lazbboregi/custom-expansion-board/staj_proje.pdf

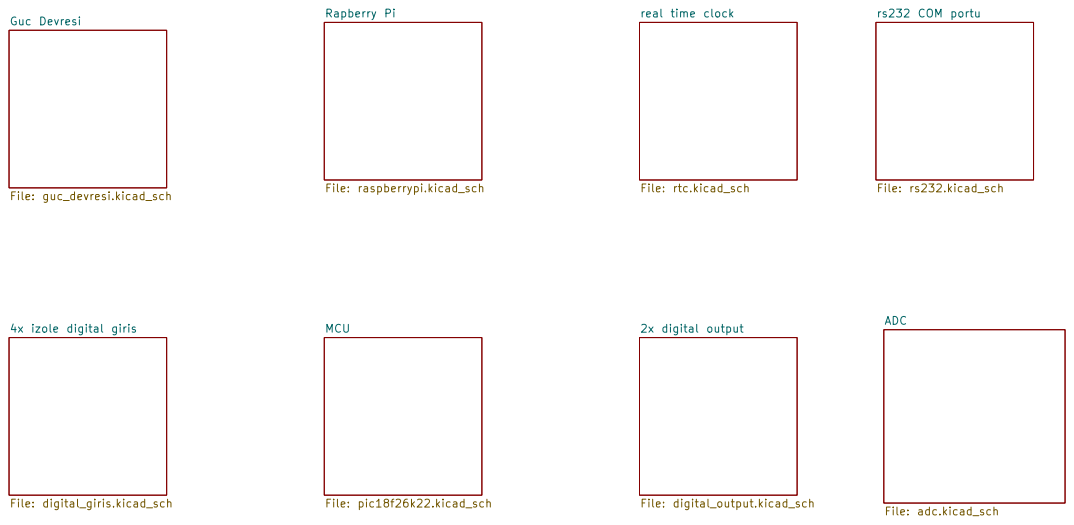
[picture p1: page 1]

File: adc.kicad_sch Rapberry Pi File: raspberrypi.kicad_sch

Size: A4 | Rev:
KiCad E.D.A. 10.0.3 | Id: 1/9

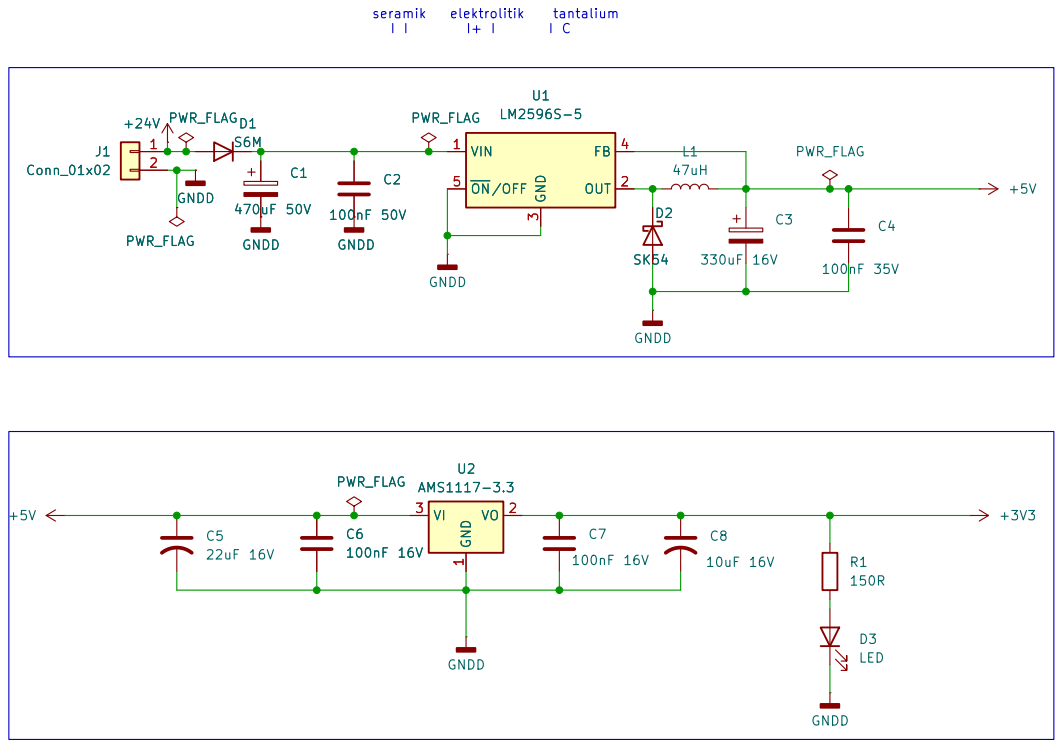
[picture p2: page 2]

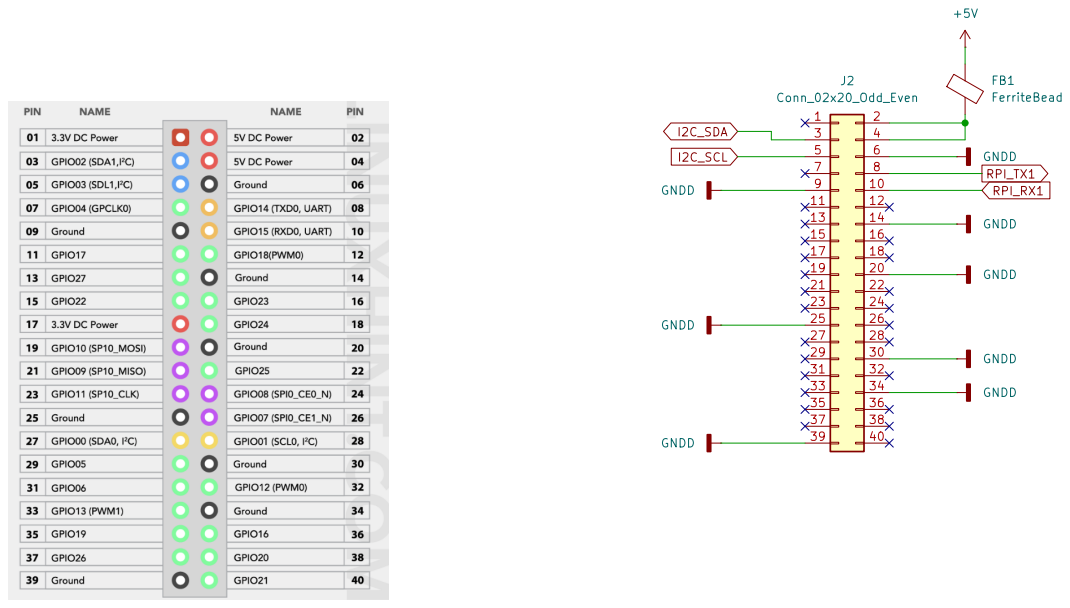
[picture p3: page 3]

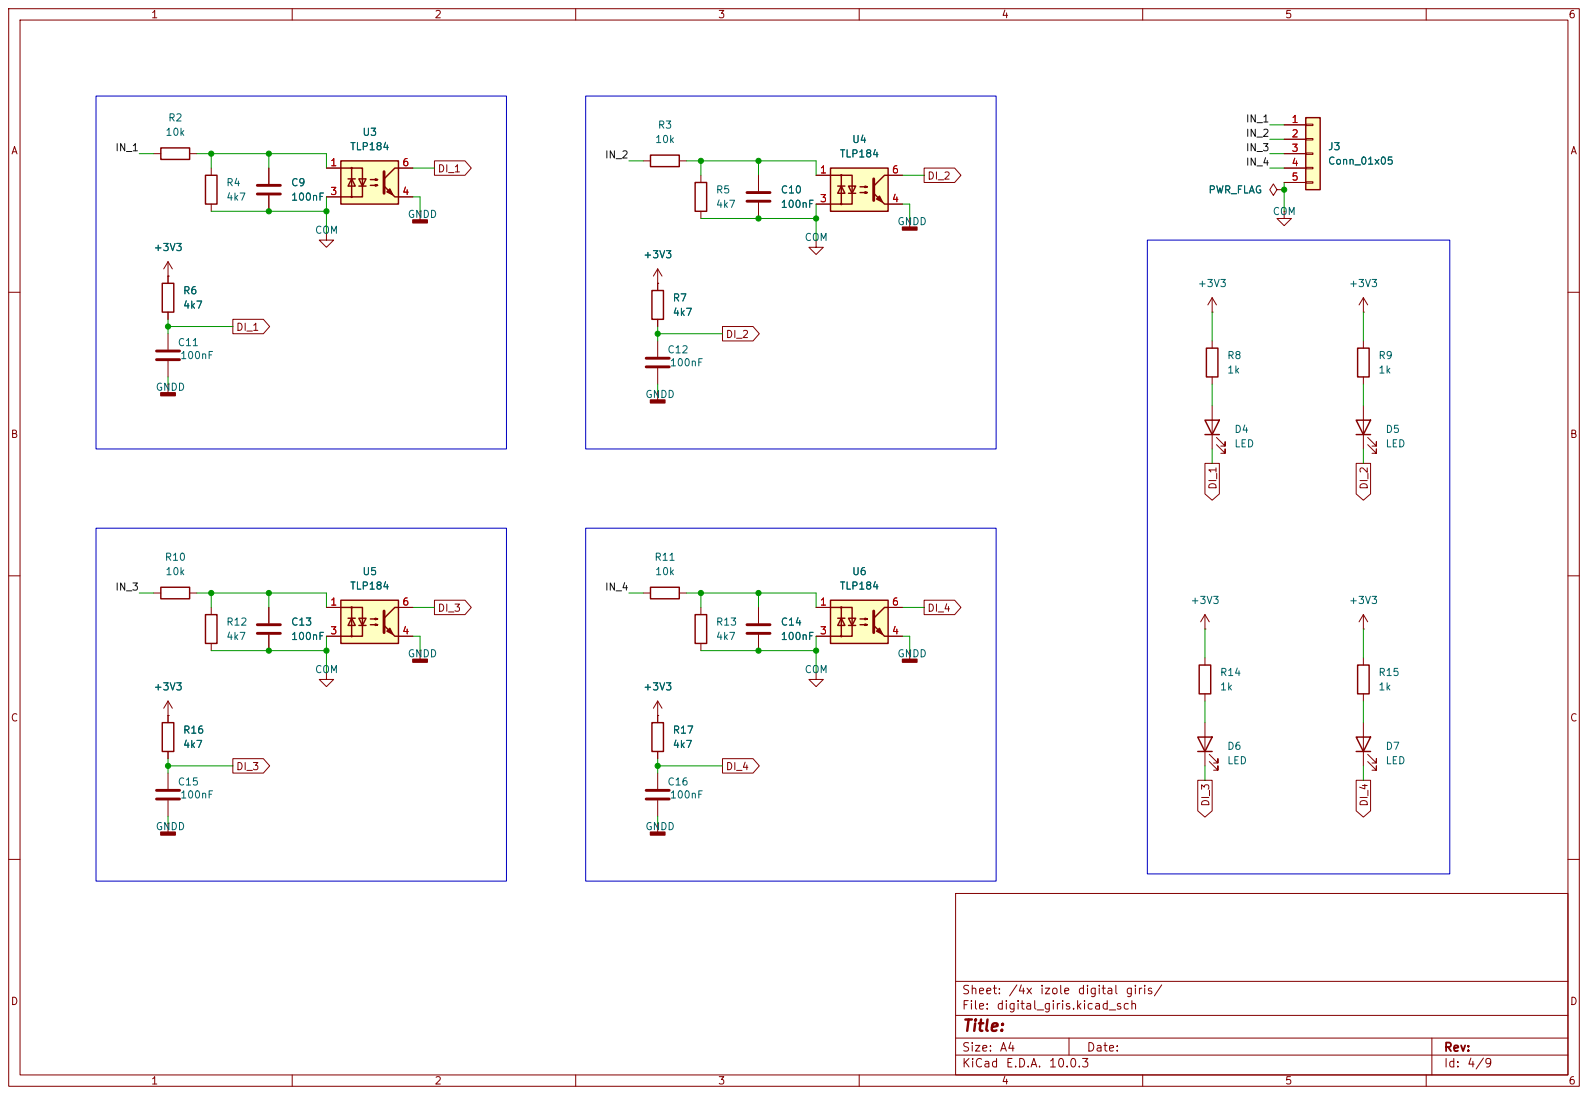
[picture p4: page 4]

Sheet: /4x izole digital giris/
File: digital_giris.kicad_sch
Title:

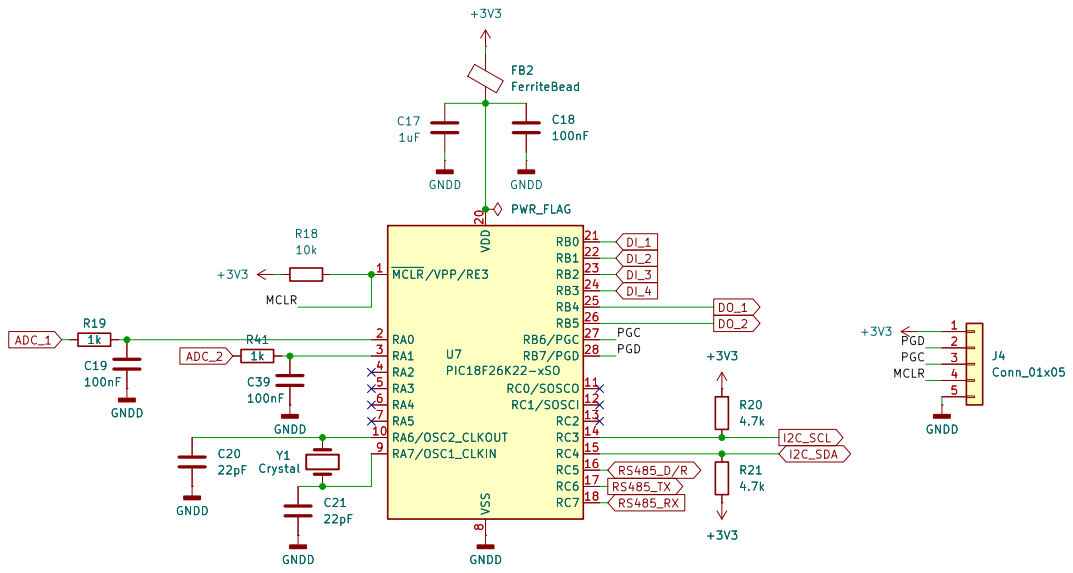
[picture p5: page 5]

8 RA7/OSC1_CLKIN 9 RA6/OSC2_CLKOUT 10 RC0/SOSCO 11 RC1/SOSCI 12 RC2 13 RC3 14 RC4 15 RC5 16 RC6 17 RC7 18 VDD 20 RB0 21 RB1 22 RB2 23 RB3 24 RB4 25 RB5 26 RB6/PGC 27 RB7/PGD 28 C21

8 RA7/OSC1_CLKIN 9 RA6/OSC2_CLKOUT 10 RC0/SOSCO 11 RC1/SOSCI 12 RC2 13 RC3 14 RC4 15 RC5 16 RC6 17 RC7 18 VDD 20 RB0 21 RB1 22 RB2 23 RB3 24 RB4 25 RB5 26 RB6/PGC 27 RB7/PGD 28 U7PIC18F26K22-xSO

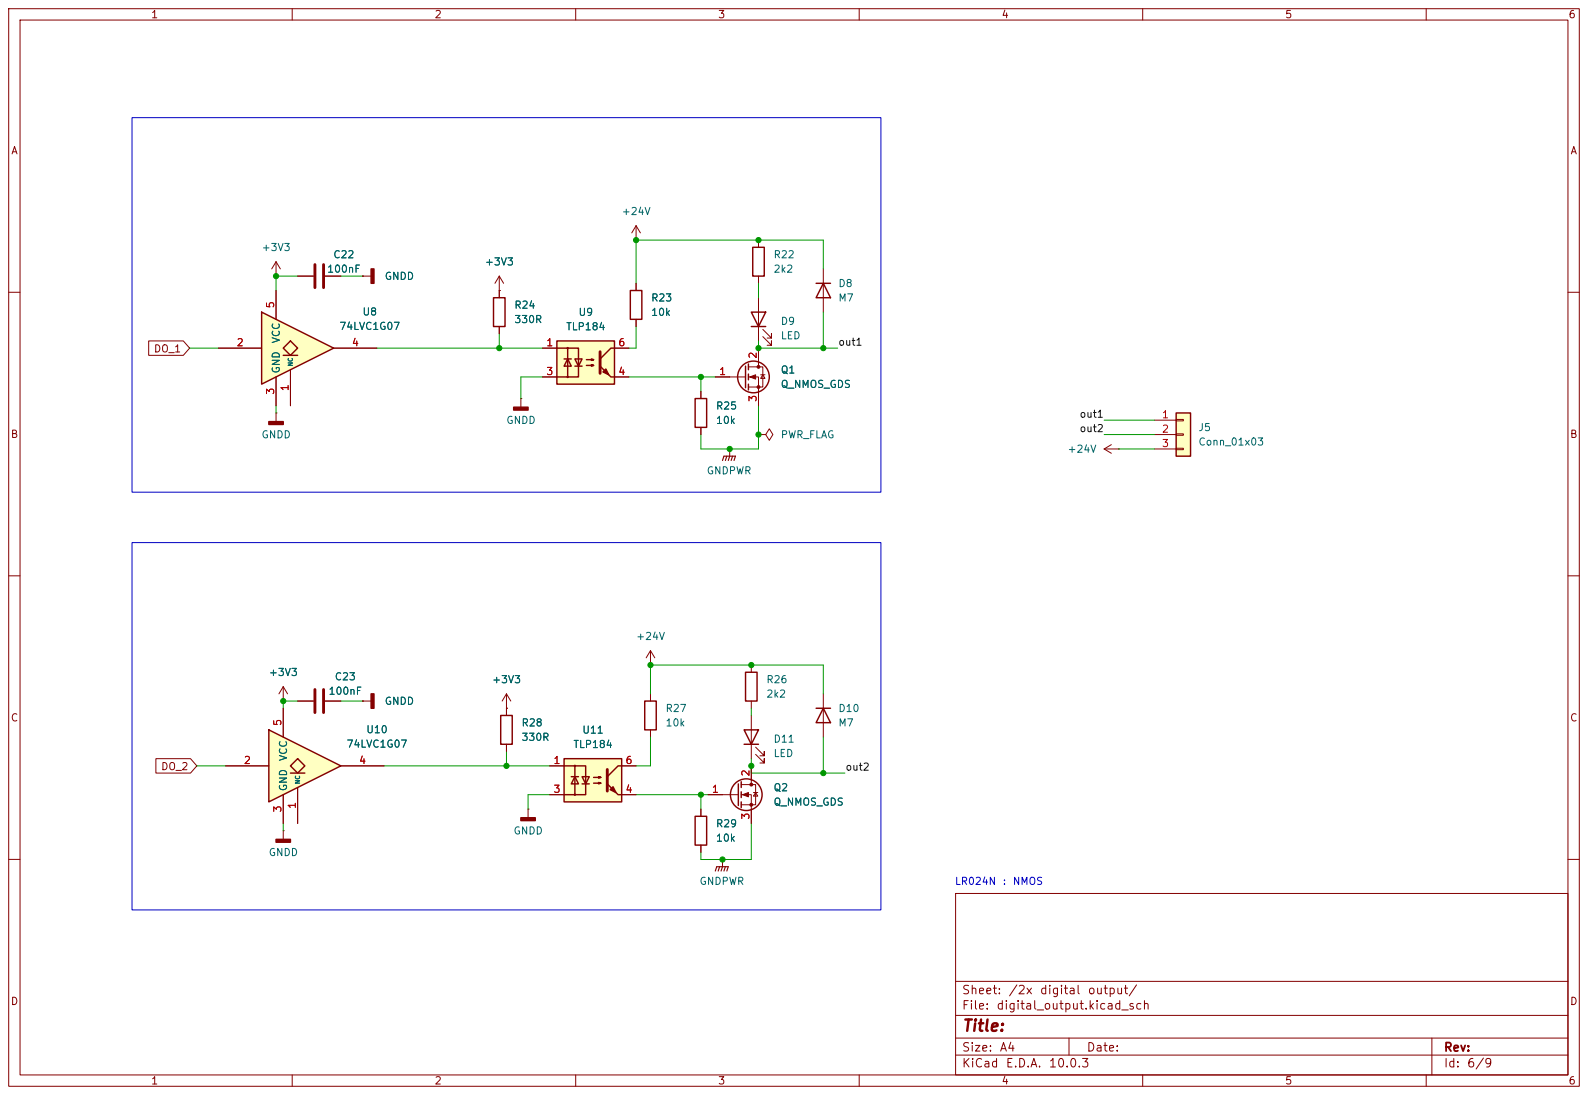
[picture p6: page 6]

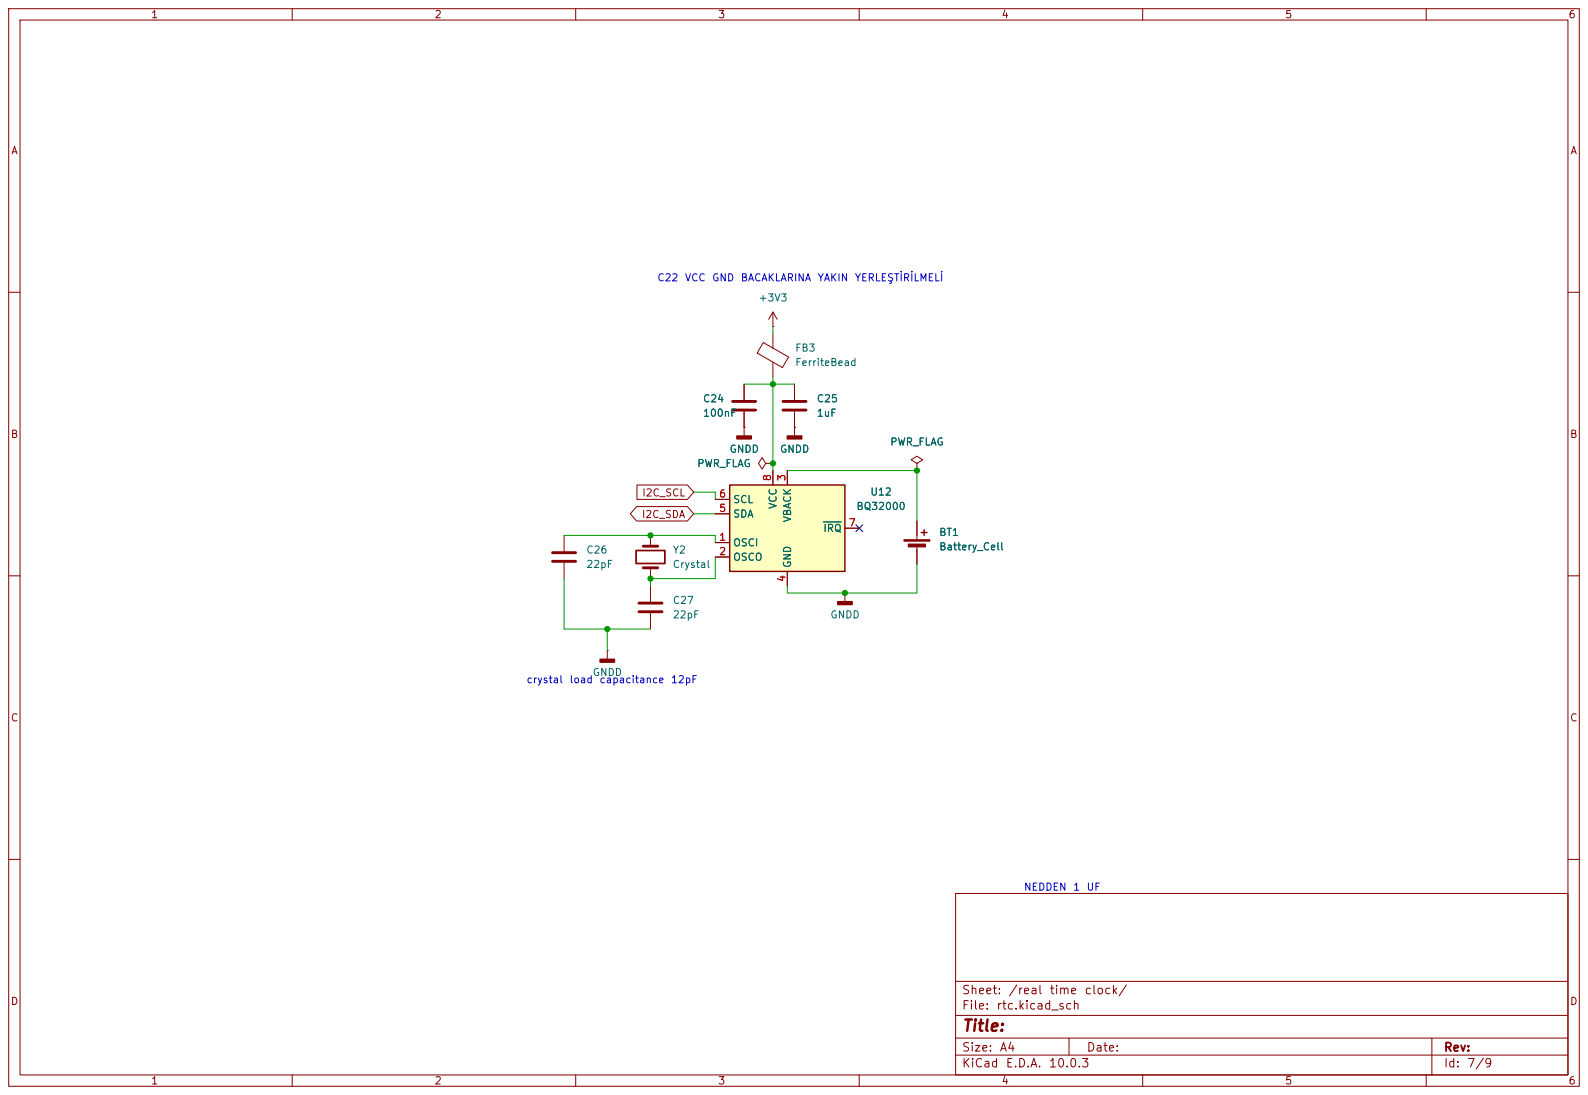
[picture p7: page 7]

Sheet: /real time clock/
File: rtc.kicad_sch
Title:

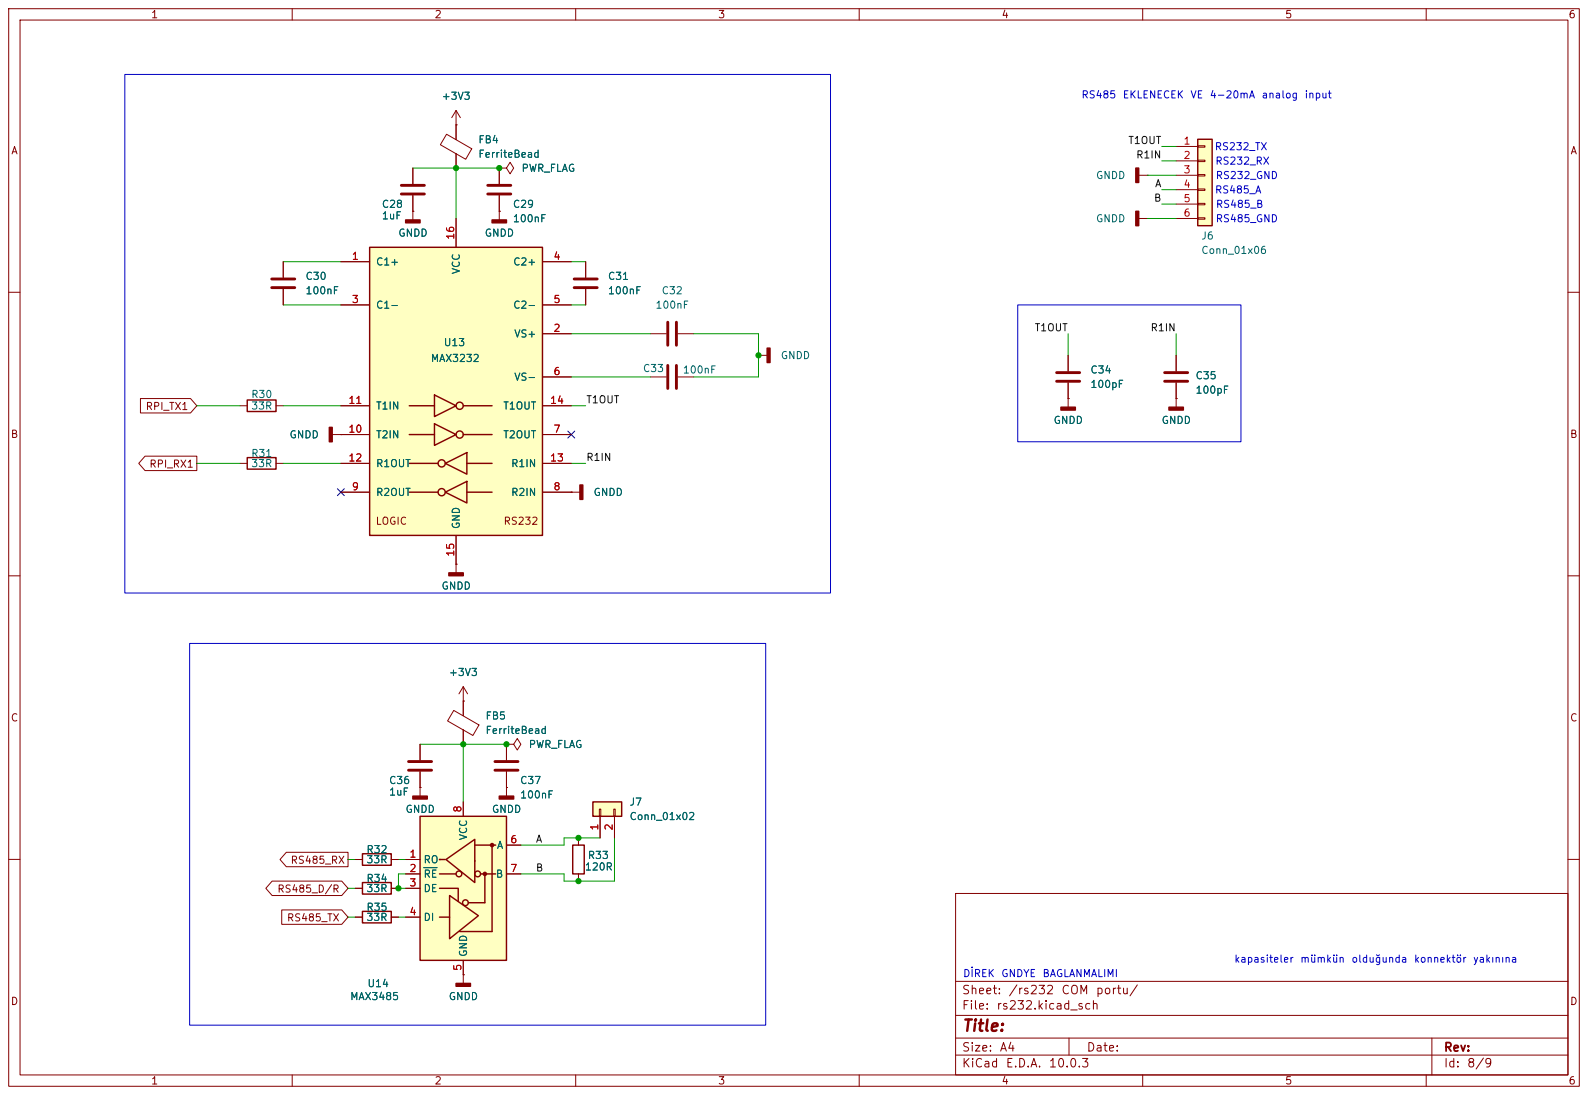
[picture p8: page 8]

RS485 EKLENECEK VE 4-20mA analog input
T1OUTB

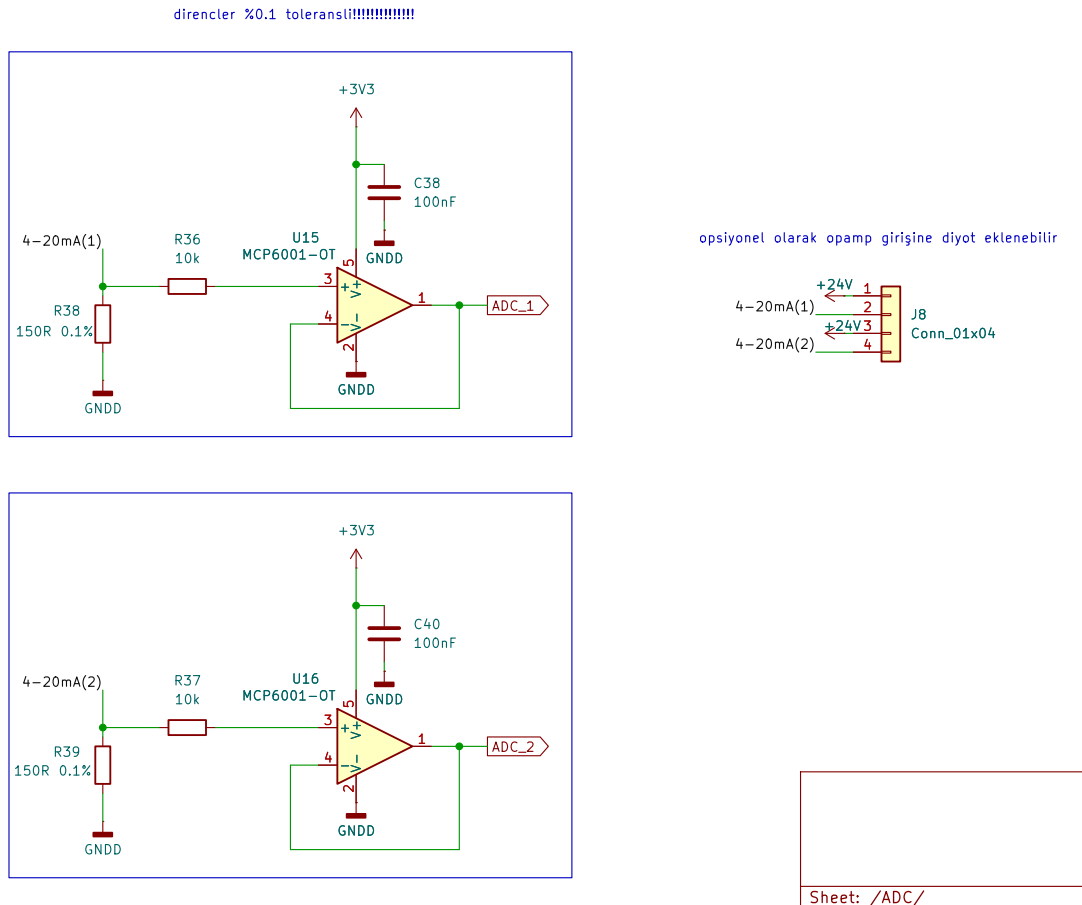
[picture p9: page 9]
