lazbboregi/custom-expansion-board/layers_pdf/staj_proje-B_Cu.pdf

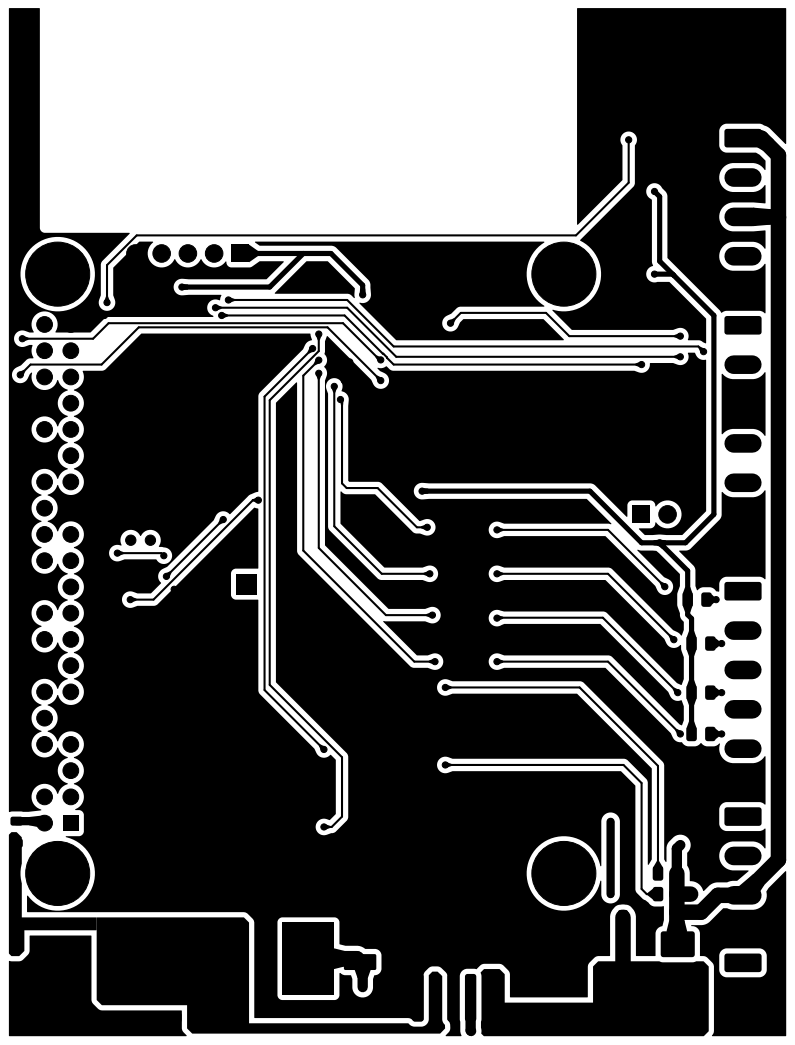
[picture p10: page 1]
