lazbboregi/custom-expansion-board/layers_pdf/staj_proje-B_Mask.pdf

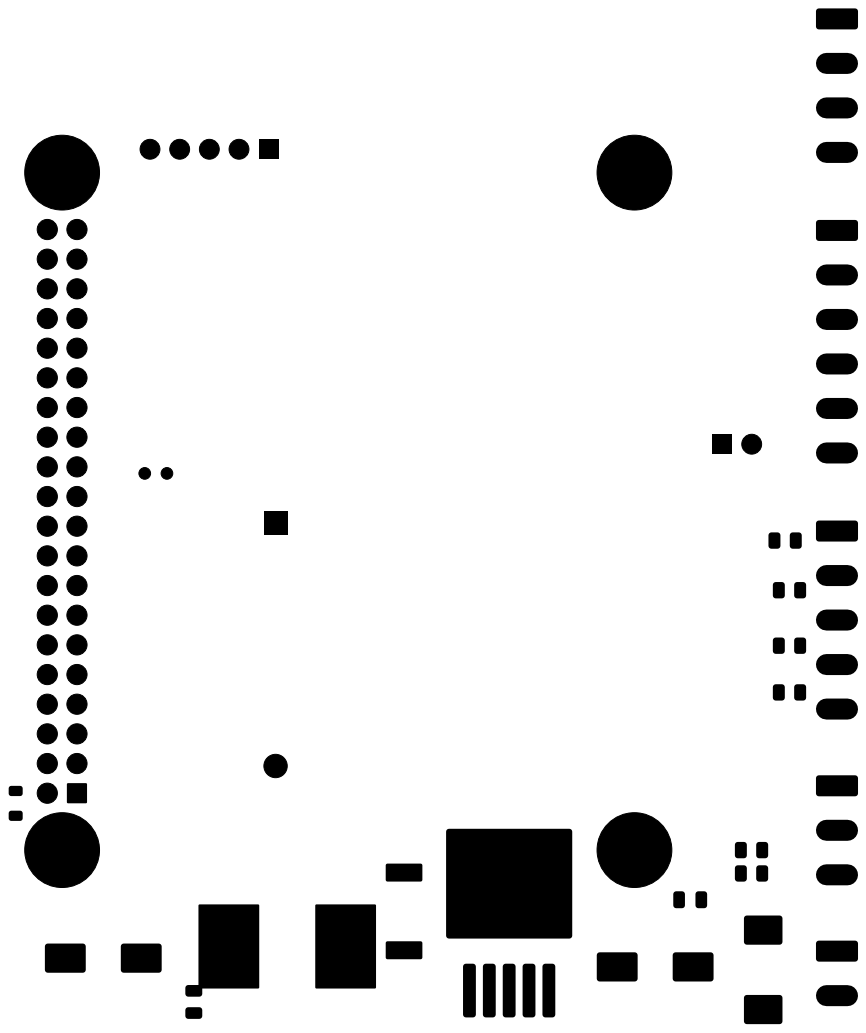
[picture p11: page 1]
