lazbboregi/custom-expansion-board/layers_pdf/staj_proje-B_Paste.pdf

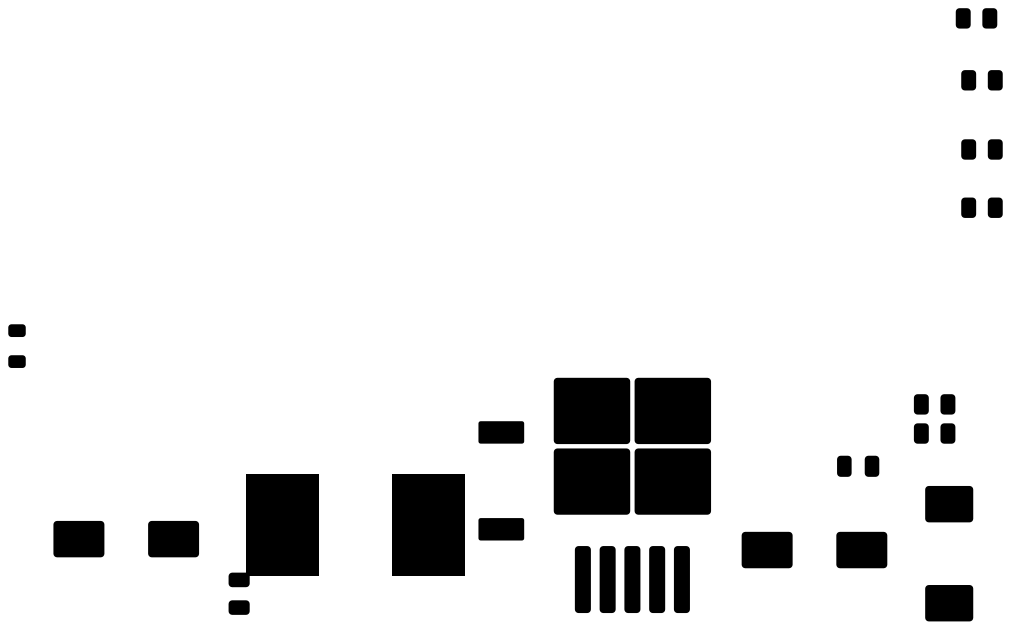
[picture p12: page 1]
