lazbboregi/custom-expansion-board/layers_pdf/staj_proje-B_Silkscreen.pdf

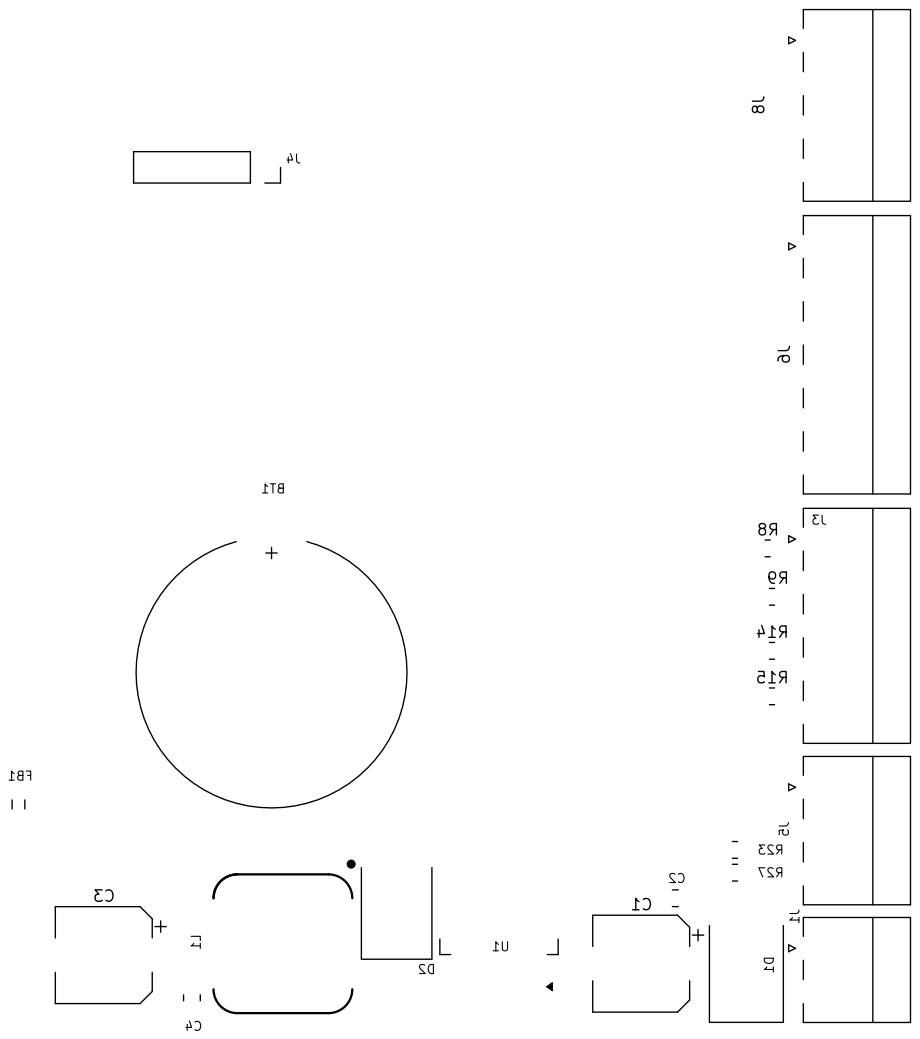
[picture p13: page 1]
