lazbboregi/custom-expansion-board/layers_pdf/staj_proje-F_Cu.pdf

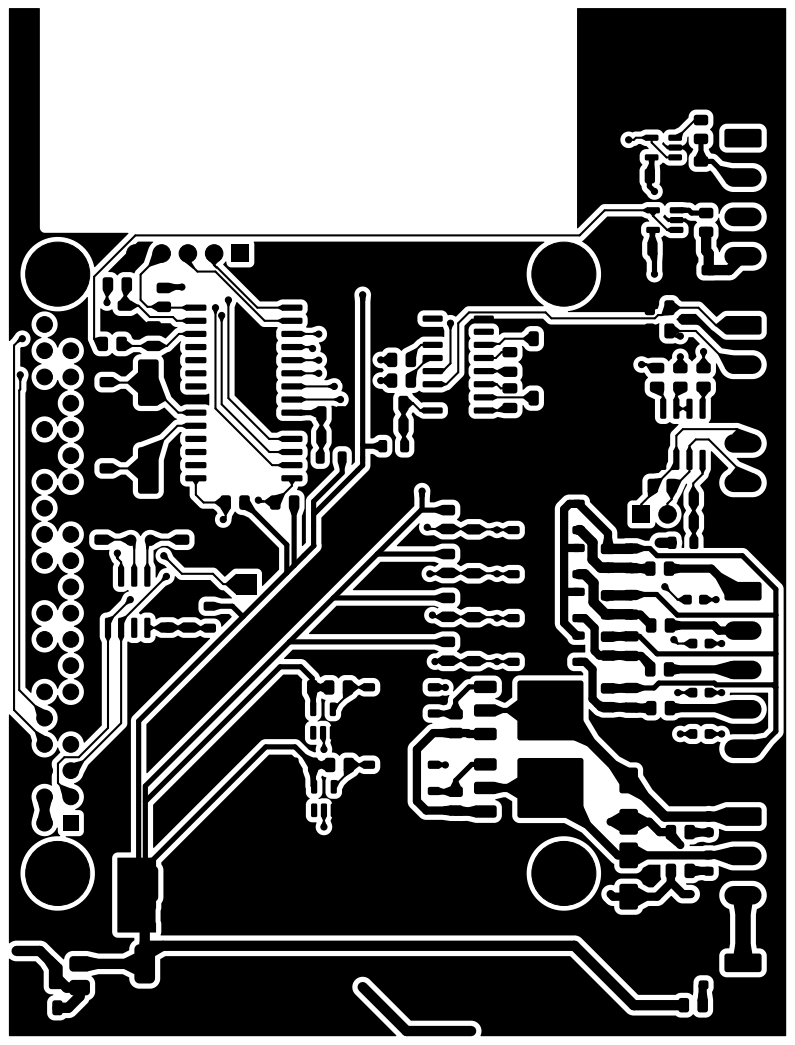
[picture p14: page 1]
