lazbboregi/custom-expansion-board/layers_pdf/staj_proje-F_Mask.pdf

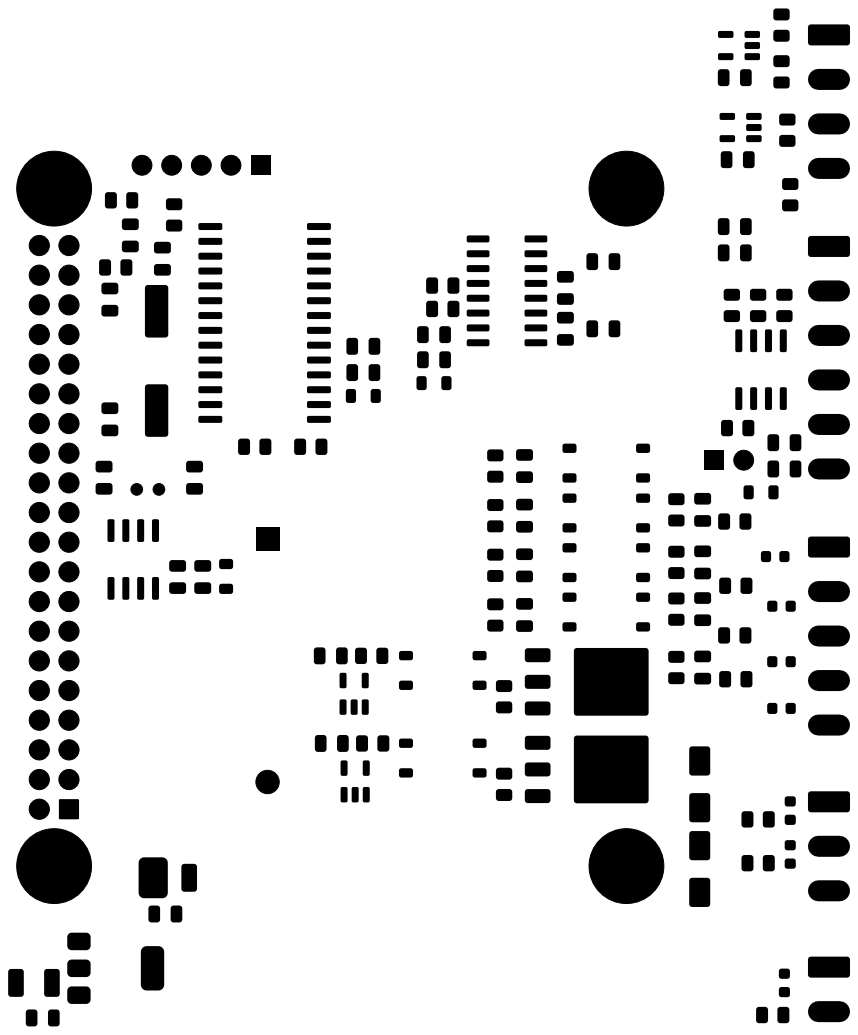
[picture p15: page 1]
