lazbboregi/custom-expansion-board/layers_pdf/staj_proje-F_Paste.pdf

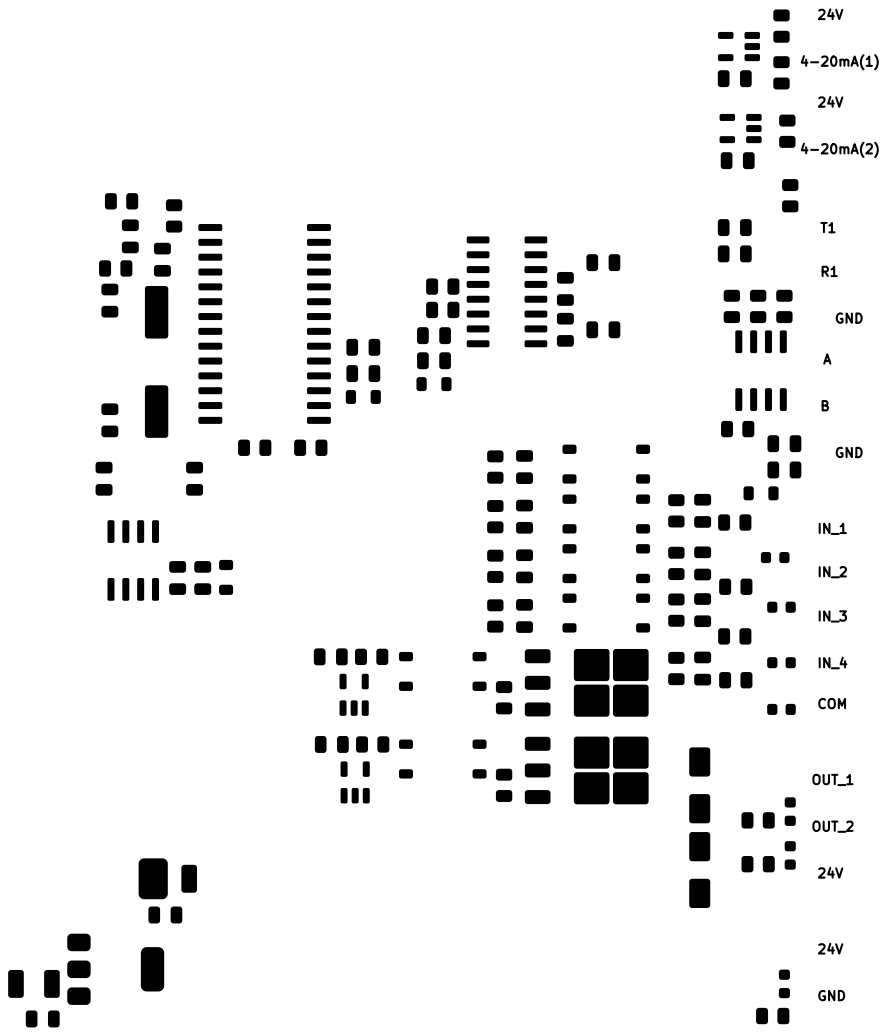
[picture p16: page 1]
