lazbboregi/custom-expansion-board/layers_pdf/staj_proje-F_Silkscreen.pdf

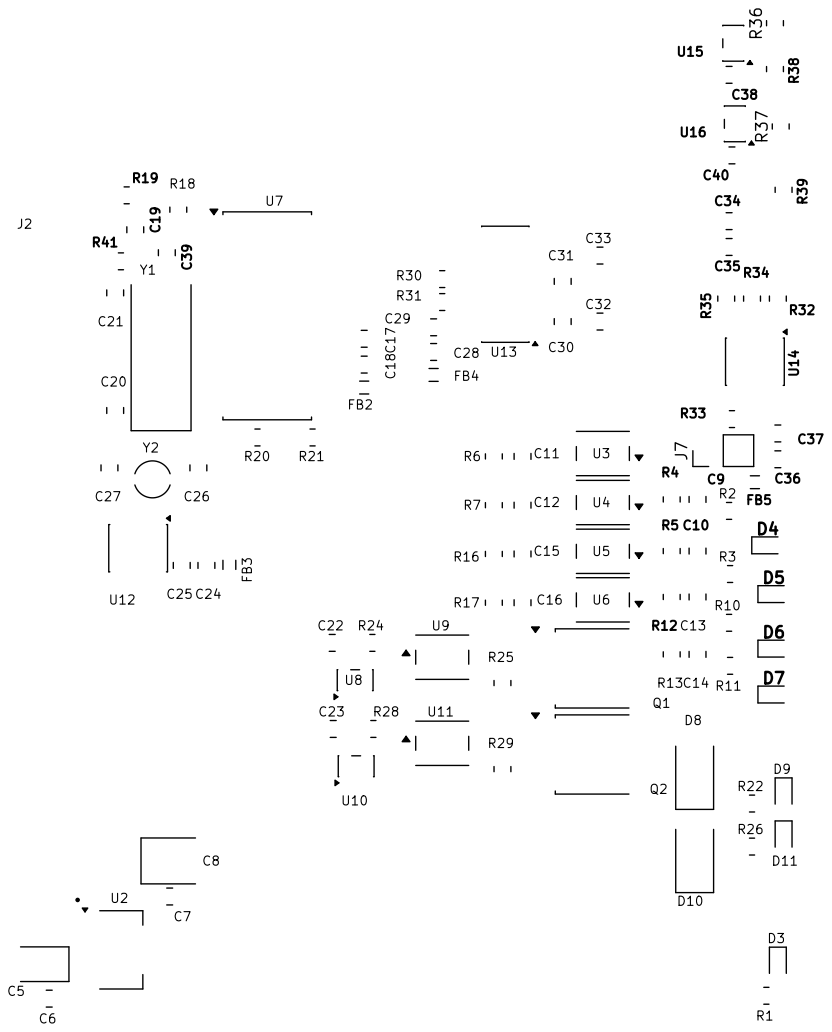
[picture p17: page 1]
