lazbboregi/custom-expansion-board/staj_proje(v3_blue).kicad_pcb

## KiCad design staj_proje(v3_blue).kicad_pcb (2026-09-11)

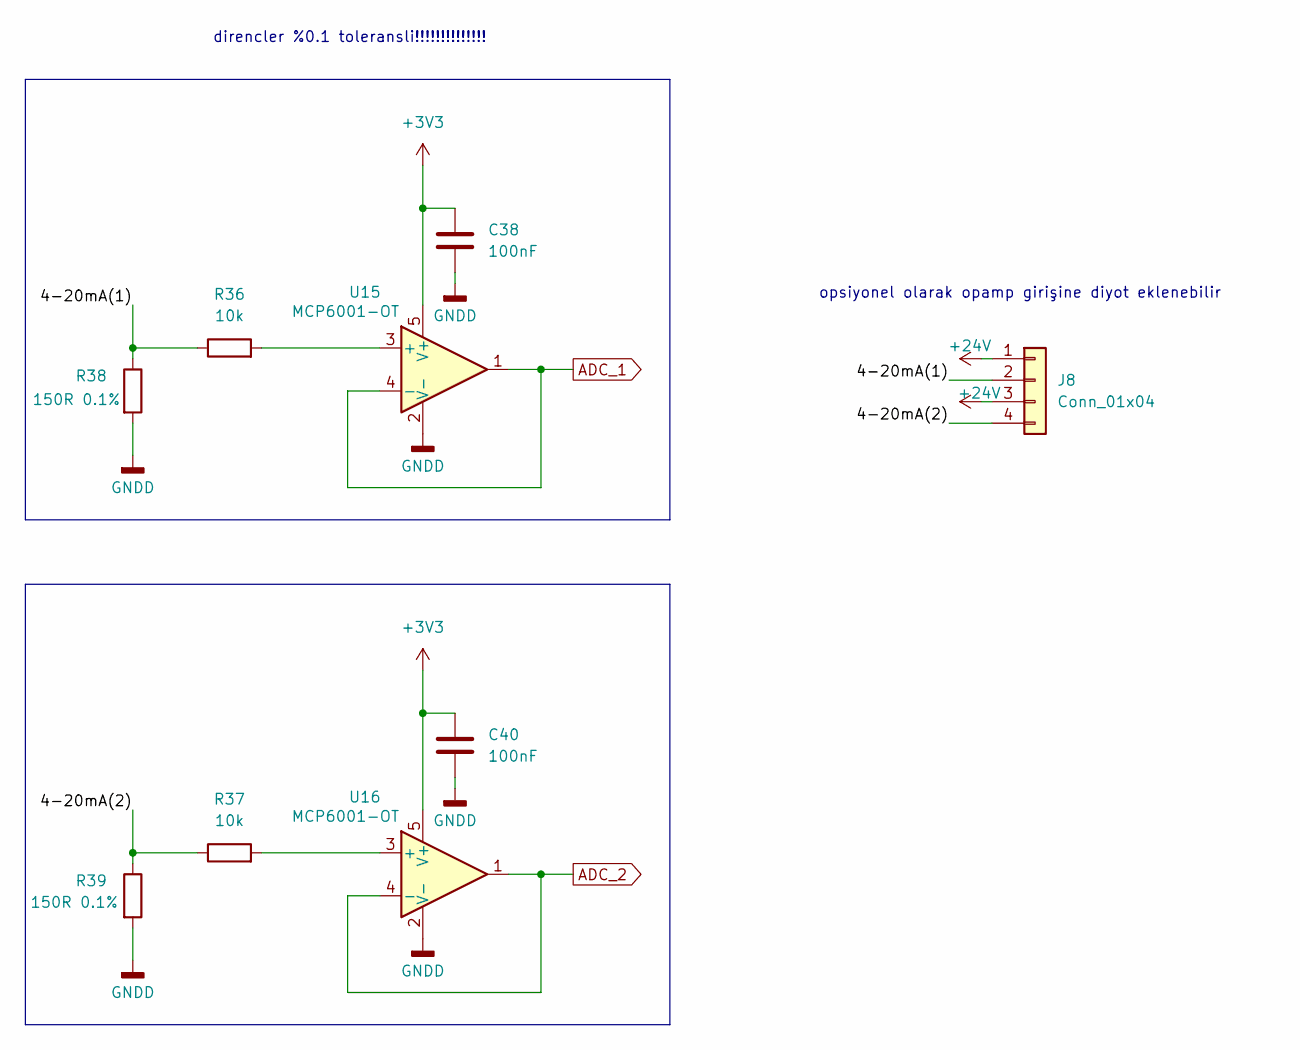
[picture p18: schematic adc.kicad_sch]

Parts:
C38, C40: 100nF; C_0805_2012Metric
J8: Conn_01x04; PhoenixContact_MC_1,5_4-G-3.81_1x04_P3.81mm_Horizontal
R36, R37: 10k; R_0805_2012Metric
R38, R39: 150R 0.1%; R_0805_2012Metric
U15, U16: MCP6001-OT; SOT-23-5

Connections:
+3V3: C38.1, C40.1, U15.5 (V+), U16.5 (V+); also elsewhere on the board
+24V: J8.1, J8.3; also elsewhere on the board
/ADC/4-20mA(1): J8.2, R36.1, R38.1
/ADC/4-20mA(2): J8.4, R37.1, R39.1
ADC_1: U15.1, U15.4 (-); also elsewhere on the board
ADC_2: U16.1, U16.4 (-); also elsewhere on the board
GNDD: C38.2, C40.2, R38.2, R39.2, U15.2 (V-), U16.2 (V-); also elsewhere on the board
unnamed: R36.2, U15.3 (+)
unnamed: R37.2, U16.3 (+)

Notes on the sheet:
direncler %0.1 toleransli!!!!!!!!!!!!!!
opsiyonel olarak opamp girişine diyot eklenebilir

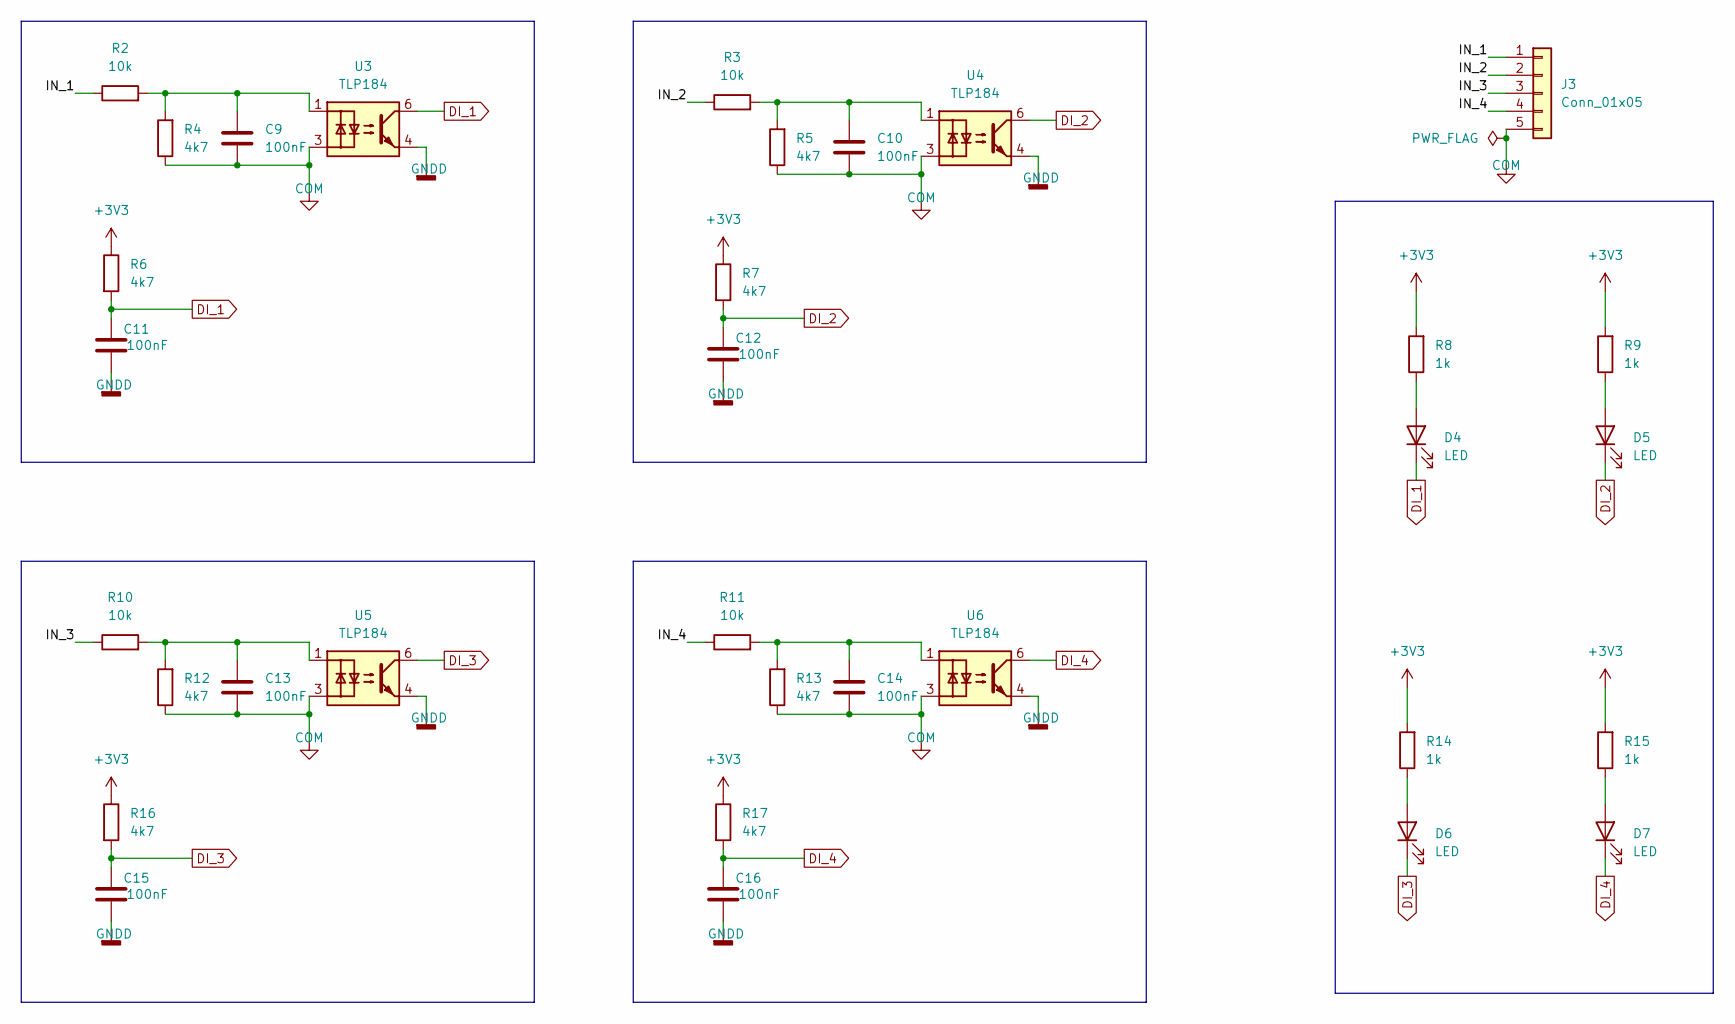
[picture p19: schematic digital_giris.kicad_sch]

Parts:
C9, C10, C11, C12, C13, C14, C15, C16: 100nF; C_0805_2012Metric
D4, D5, D6, D7: LED; LED_0603_1608Metric
J3: Conn_01x05; PhoenixContact_MC_1,5_5-G-3.81_1x05_P3.81mm_Horizontal
R2, R3, R10, R11: 10k; R_0805_2012Metric
R4, R5, R6, R7, R12, R13, R16, R17: 4k7; R_0805_2012Metric
R8, R9, R14, R15: 1k; R_0805_2012Metric
U3, U4, U5, U6: TLP184; Toshiba_SOIC-4-6_4.4x3.6mm_P1.27mm

Connections:
+3V3: R6.1, R7.1, R8.2, R9.2, R14.2, R15.2, R16.1, R17.1; also elsewhere on the board
/4x izole digital giris/IN_1: J3.1, R2.1
/4x izole digital giris/IN_2: J3.2, R3.1
/4x izole digital giris/IN_3: J3.3, R10.1
/4x izole digital giris/IN_4: J3.4, R11.1
COM: C9.1, C10.1, C13.1, C14.1, J3.5, R4.1, R5.1, R12.1, R13.1, U3.3, U4.3, U5.3, U6.3
DI_1: C11.1, D4.1 (K), R6.2, U3.6; also elsewhere on the board
DI_2: C12.1, D5.1 (K), R7.2, U4.6; also elsewhere on the board
DI_3: C15.1, D6.1 (K), R16.2, U5.6; also elsewhere on the board
DI_4: C16.1, D7.1 (K), R17.2, U6.6; also elsewhere on the board
GNDD: C11.2, C12.2, C15.2, C16.2, U3.4, U4.4, U5.4, U6.4; also elsewhere on the board
unnamed: C9.2, R2.2, R4.2, U3.1
unnamed: C10.2, R3.2, R5.2, U4.1
unnamed: C13.2, R10.2, R12.2, U5.1
unnamed: C14.2, R11.2, R13.2, U6.1
unnamed: D4.2 (A), R8.1
unnamed: D5.2 (A), R9.1
unnamed: D6.2 (A), R14.1
unnamed: D7.2 (A), R15.1

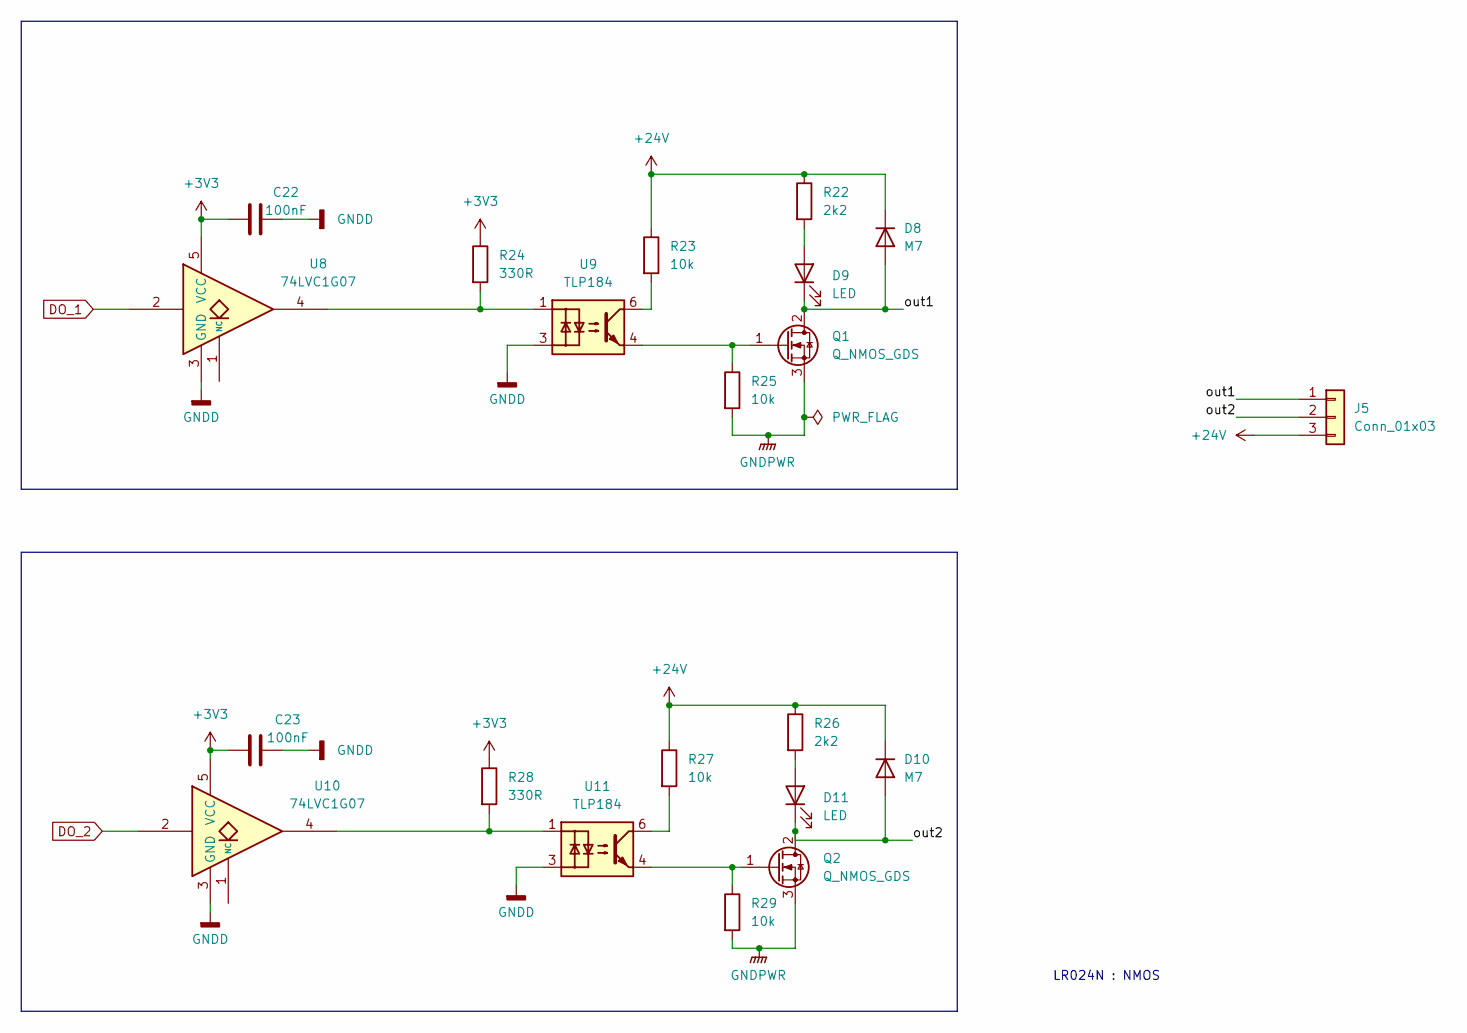
[picture p20: schematic digital_output.kicad_sch]

Parts:
C22, C23: 100nF; C_0805_2012Metric
D8, D10: M7; D_SMA
D9, D11: LED; LED_0603_1608Metric
J5: Conn_01x03; PhoenixContact_MC_1,5_3-G-3.81_1x03_P3.81mm_Horizontal
Q1, Q2: Q_NMOS_GDS; TO-252-3_TabPin2
R22, R26: 2k2; R_0805_2012Metric
R23, R25, R27, R29: 10k; R_0805_2012Metric
R24, R28: 330R; R_0805_2012Metric
U8, U10: 74LVC1G07; SOT-23-5
U9, U11: TLP184; Toshiba_SOIC-4-6_4.4x3.6mm_P1.27mm

Connections:
+3V3: C22.2, C23.2, R24.1, R28.1, U8.5 (VCC), U10.5 (VCC); also elsewhere on the board
+24V: D8.1 (K), D10.1 (K), J5.3, R22.1, R23.1, R26.1, R27.1; also elsewhere on the board
/2x digital output/out1: D8.2 (A), D9.1 (K), J5.1, Q1.2 (D)
/2x digital output/out2: D10.2 (A), D11.1 (K), J5.2, Q2.2 (D)
DO_1: U8.2; also elsewhere on the board
DO_2: U10.2; also elsewhere on the board
GNDD: C22.1, C23.1, U8.3 (GND), U9.3, U10.3 (GND), U11.3; also elsewhere on the board
GNDPWR: Q1.3 (S), Q2.3 (S), R25.2, R29.2
unnamed: D9.2 (A), R22.2
unnamed: D11.2 (A), R26.2
unnamed: Q1.1 (G), R25.1, U9.4
unnamed: Q2.1 (G), R29.1, U11.4
unnamed: R23.2, U9.6
unnamed: R24.2, U8.4, U9.1
unnamed: R27.2, U11.6
unnamed: R28.2, U10.4, U11.1

Notes on the sheet:
LR024N : NMOS

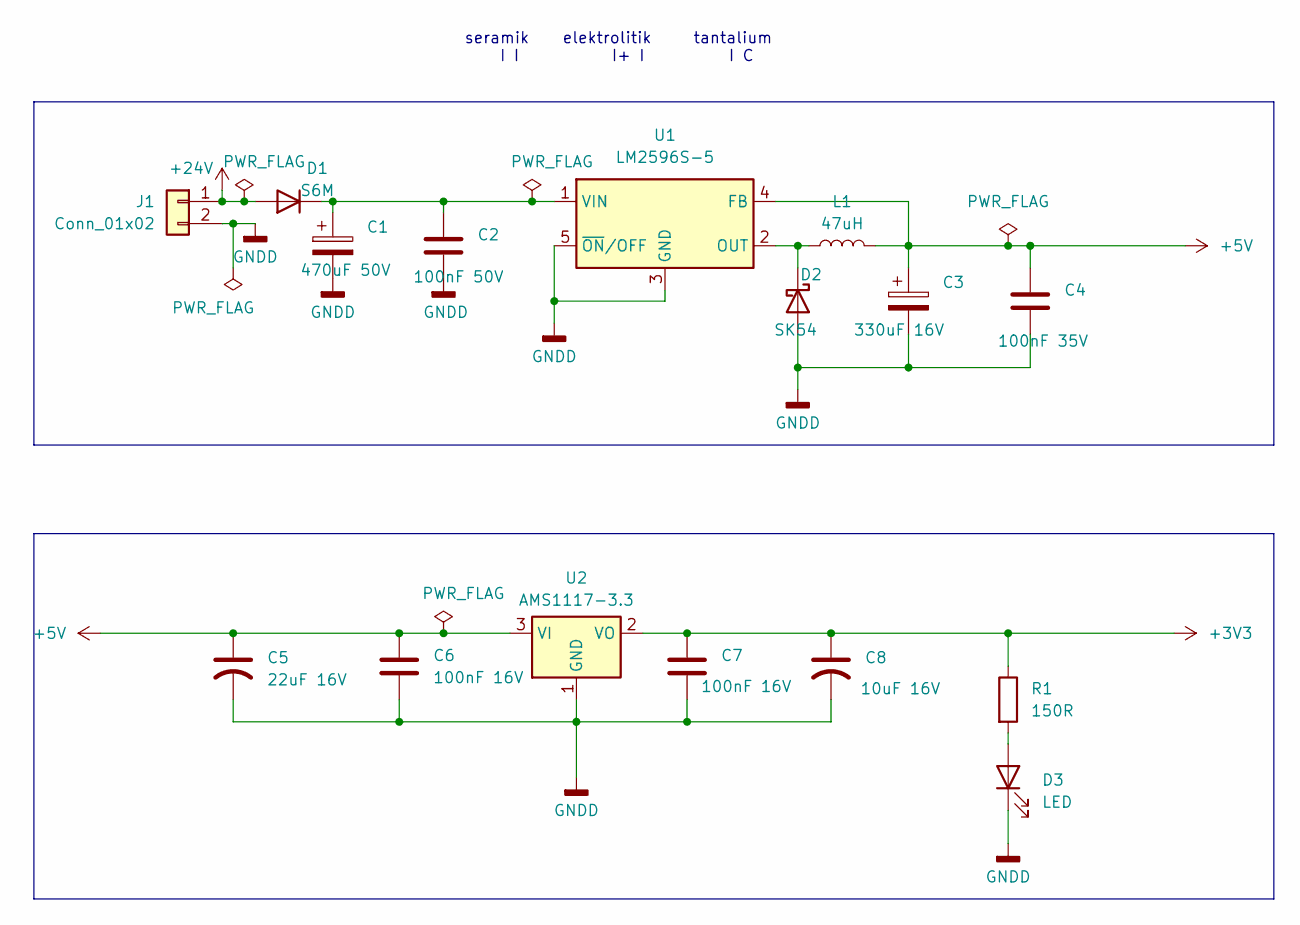
[picture p21: schematic guc_devresi.kicad_sch]

Parts:
C1: 470uF 50V; CP_Elec_8x10
C2: 100nF 50V; C_0805_2012Metric
C3: 330uF 16V; CP_Elec_8x10
C4: 100nF 35V; C_0805_2012Metric
C5: 22uF 16V; CP_EIA-3528-21_Kemet-B
C6, C7: 100nF 16V; C_0805_2012Metric
C8: 10uF 16V; CP_EIA-3528-21_Kemet-B
D1: S6M; D_SMC
D2: SK54; ST_D_SMC
D3: LED; LED_0603_1608Metric
J1: Conn_01x02; PhoenixContact_MC_1,5_2-G-3.81_1x02_P3.81mm_Horizontal
L1: 47uH; WE-PD_1210
R1: 150R; R_0805_2012Metric
U1: LM2596S-5; TO-263-5_TabPin3
U2: AMS1117-3.3; SOT-223-3_TabPin2

Connections:
+3V3: C7.1, C8.1, R1.1, U2.2 (VO); also elsewhere on the board
+5V: C3.1, C4.1, C5.1, C6.1, L1.2, U1.4 (FB), U2.3 (VI); also elsewhere on the board
+24V: D1.2 (A), J1.1; also elsewhere on the board
GNDD: C1.2, C2.2, C3.2, C4.2, C5.2, C6.2, C7.2, C8.2, D2.2 (A), D3.1 (K), J1.2, U1.3 (GND), U1.5 (~ON/OFF), U2.1 (GND); also elsewhere on the board
unnamed: C1.1, C2.1, D1.1 (K), U1.1 (VIN)
unnamed: D2.1 (K), L1.1, U1.2 (OUT)
unnamed: D3.2 (A), R1.2

Notes on the sheet:
seramik elektrolitik tantalium I I I+ I I C

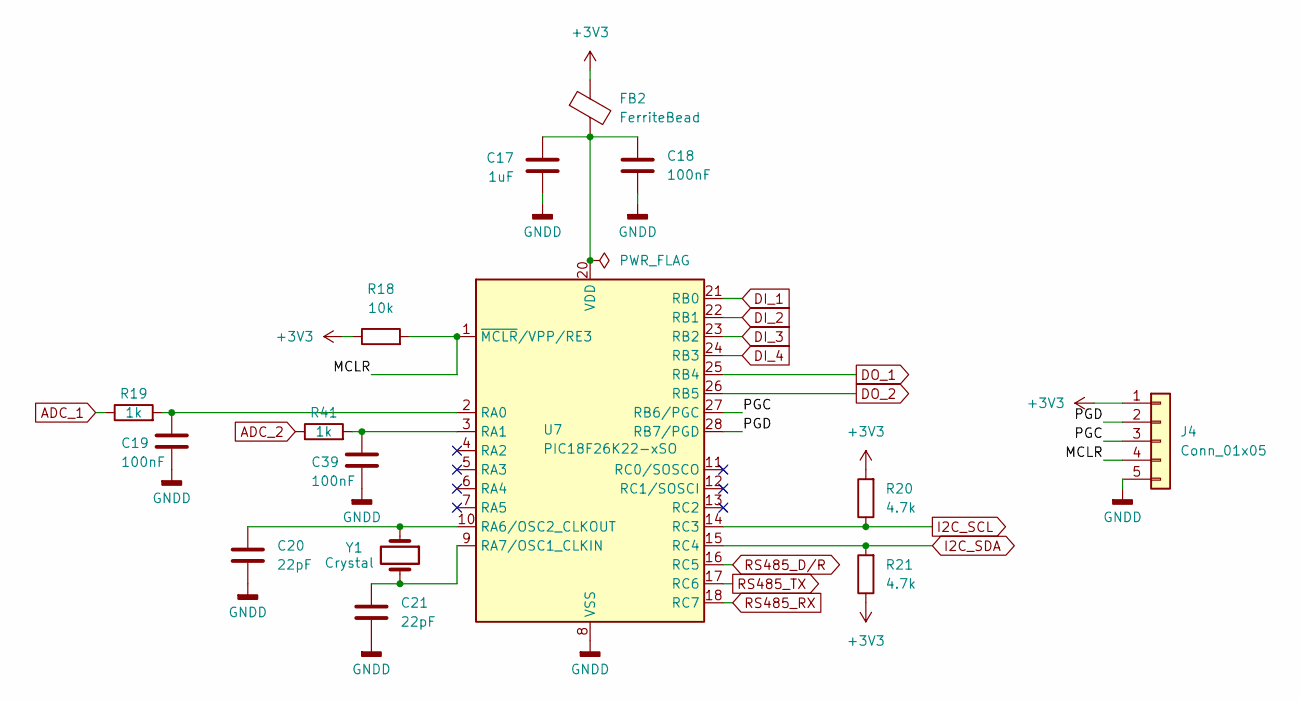
[picture p22: schematic pic18f26k22.kicad_sch]

Parts:
C17: 1uF; C_0805_2012Metric
C18, C19, C39: 100nF; C_0805_2012Metric
C20, C21: 22pF; C_0805_2012Metric
FB2: FerriteBead; L_0805_2012Metric
J4: Conn_01x05; PinHeader_1x05_P2.54mm_Vertical
R18: 10k; R_0805_2012Metric
R19, R41: 1k; R_0805_2012Metric
R20, R21: 4.7k; R_0805_2012Metric
U7: PIC18F26K22-xSO; SOIC-28W_7.5x17.9mm_P1.27mm
Y1: Crystal; Crystal_SMD_HC49-SD

Connections:
+3V3: FB2.1, J4.1, R18.1, R20.2, R21.1; also elsewhere on the board
/MCU/MCLR: J4.4, R18.2, U7.1 (~MCLR/VPP/RE3)
/MCU/PGC: J4.3, U7.27 (RB6/PGC)
/MCU/PGD: J4.2, U7.28 (RB7/PGD)
ADC_1: R19.1; also elsewhere on the board
ADC_2: R41.1; also elsewhere on the board
DI_1: U7.21 (RB0); also elsewhere on the board
DI_2: U7.22 (RB1); also elsewhere on the board
DI_3: U7.23 (RB2); also elsewhere on the board
DI_4: U7.24 (RB3); also elsewhere on the board
DO_1: U7.25 (RB4); also elsewhere on the board
DO_2: U7.26 (RB5); also elsewhere on the board
GNDD: C17.1, C18.2, C19.2, C20.2, C21.2, C39.2, J4.5, U7.8 (VSS), U7.19 (VSS); also elsewhere on the board
I2C_SCL: R20.1, U7.14 (RC3); also elsewhere on the board
I2C_SDA: R21.2, U7.15 (RC4); also elsewhere on the board
unnamed: C19.1, R19.2, U7.2 (RA0)
unnamed: C39.1, R41.2, U7.3 (RA1)
unnamed: C20.1, U7.10 (RA6/OSC2_CLKOUT), Y1.1
unnamed: C21.1, U7.9 (RA7/OSC1_CLKIN), Y1.2
unnamed: C17.2, C18.1, FB2.2, U7.20 (VDD)
RS485_D/R: U7.16 (RC5); also elsewhere on the board
RS485_RX: U7.18 (RC7); also elsewhere on the board
RS485_TX: U7.17 (RC6); also elsewhere on the board

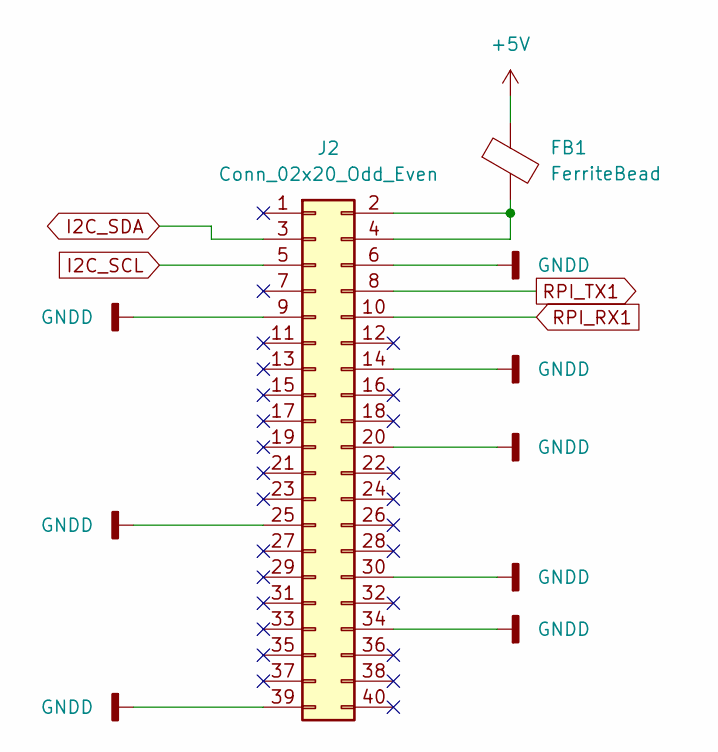
[picture p23: schematic raspberrypi.kicad_sch]

Parts:
FB1: FerriteBead; L_0805_2012Metric
J2: Conn_02x20_Odd_Even; RaspberryPİ4

Connections:
+5V: FB1.1; also elsewhere on the board
GNDD: J2.6, J2.9, J2.14, J2.20, J2.25, J2.30, J2.34, J2.39; also elsewhere on the board
I2C_SCL: J2.5; also elsewhere on the board
I2C_SDA: J2.3; also elsewhere on the board
unnamed: FB1.2, J2.2, J2.4
RPI_RX1: J2.10; also elsewhere on the board
RPI_TX1: J2.8; also elsewhere on the board

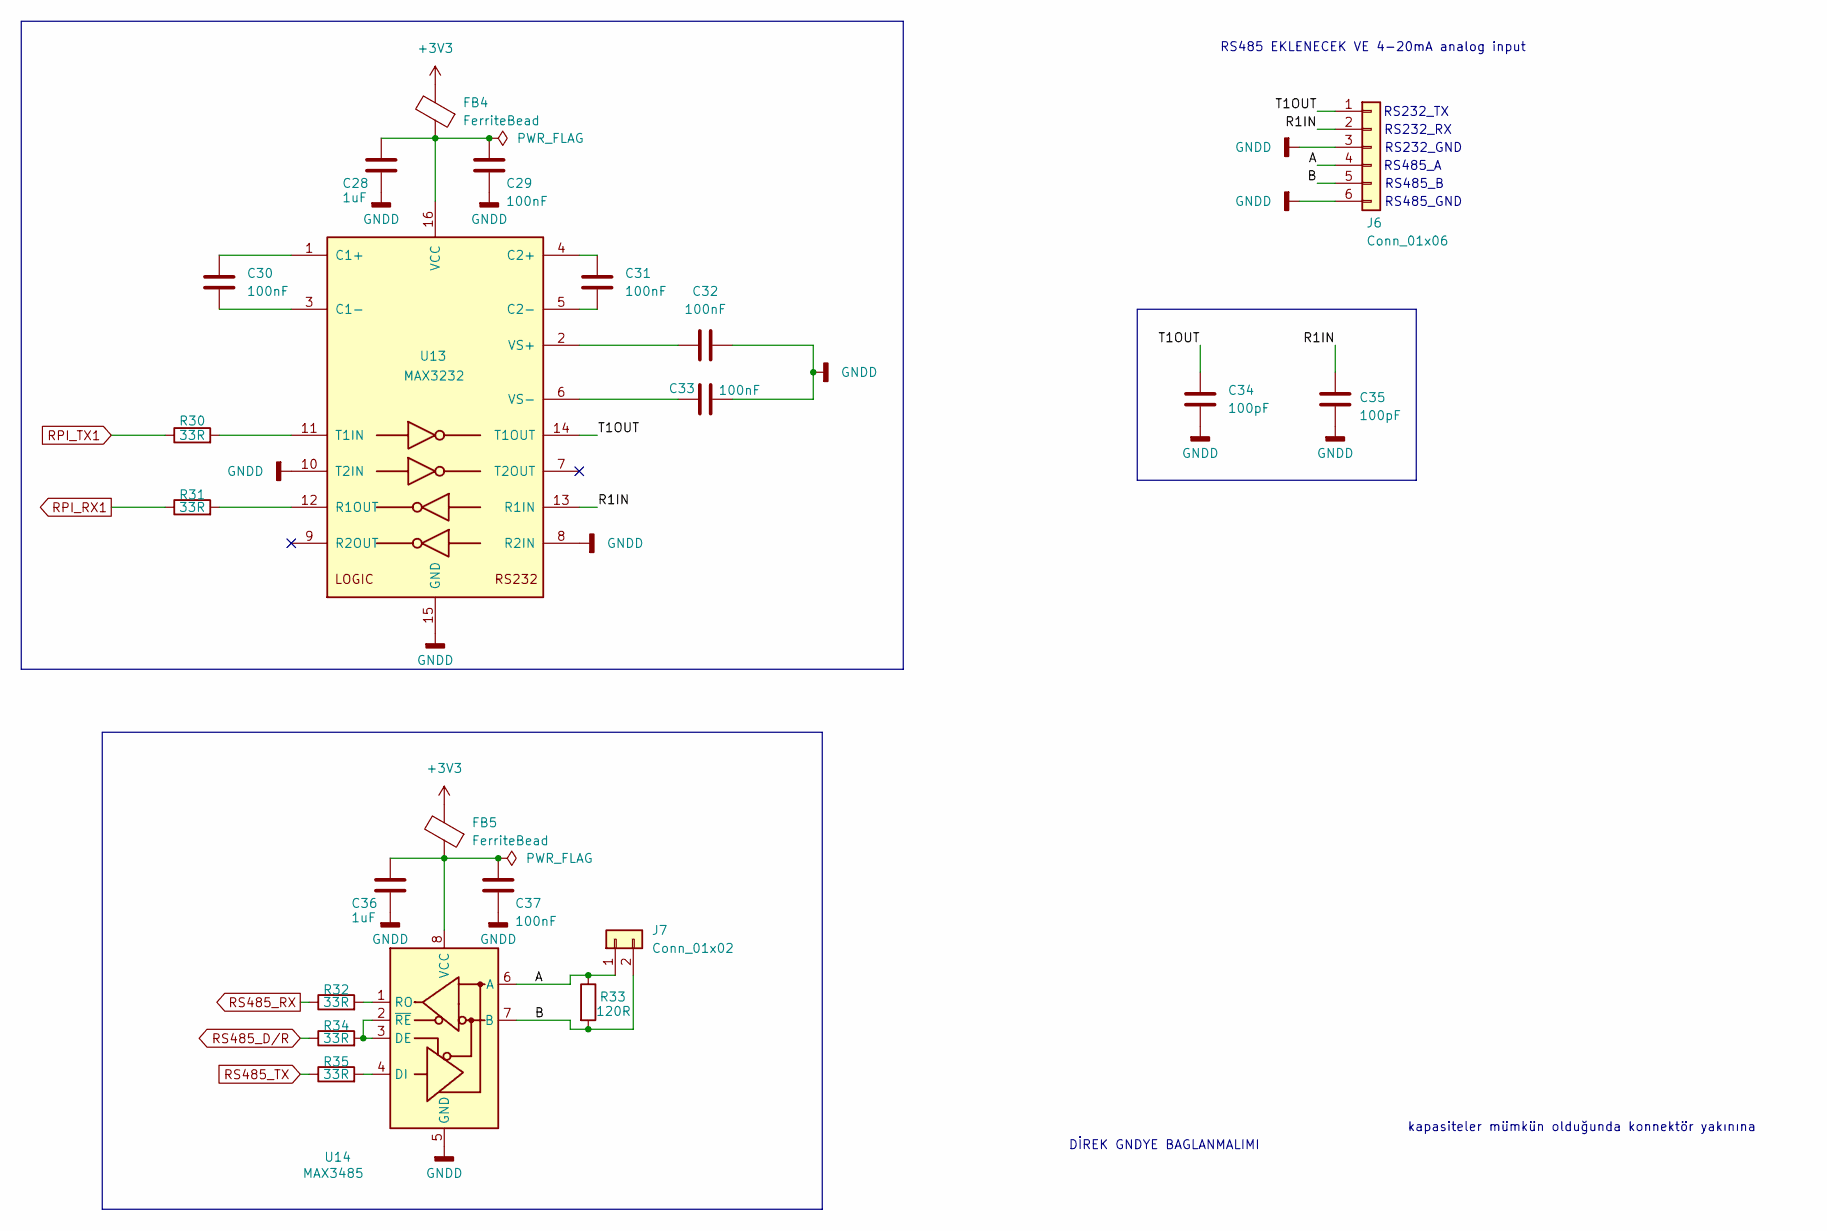
[picture p24: schematic rs232.kicad_sch]

Parts:
C28, C36: 1uF; C_0805_2012Metric
C29, C30, C31, C32, C33, C37: 100nF; C_0805_2012Metric
C34, C35: 100pF; C_0805_2012Metric
FB4, FB5: FerriteBead; L_0805_2012Metric
J6: Conn_01x06; PhoenixContact_MC_1,5_6-G-3.81_1x06_P3.81mm_Horizontal
J7: Conn_01x02; PinHeader_1x02_P2.54mm_Vertical
R30, R31, R32, R34, R35: 33R; R_0805_2012Metric
R33: 120R; R_0805_2012Metric
U13: MAX3232; SOIC-16_3.9x9.9mm_P1.27mm
U14: MAX3485; SOIC-8_3.9x4.9mm_P1.27mm

Connections:
+3V3: FB4.2, FB5.2; also elsewhere on the board
/rs232 COM portu/A: J6.4, J7.1, R33.1, U14.6 (A)
/rs232 COM portu/B: J6.5, J7.2, R33.2, U14.7 (B)
/rs232 COM portu/R1IN: C35.1, J6.2, U13.13 (R1IN)
/rs232 COM portu/T1OUT: C34.1, J6.1, U13.14 (T1OUT)
GNDD: C28.1, C29.2, C32.2, C33.2, C34.2, C35.2, C36.1, C37.2, J6.3, J6.6, U13.8 (R2IN), U13.10 (T2IN), U13.15 (GND), U14.5 (GND); also elsewhere on the board
unnamed: C30.1, U13.1 (C1+)
unnamed: C30.2, U13.3 (C1-)
unnamed: C31.1, U13.4 (C2+)
unnamed: C31.2, U13.5 (C2-)
unnamed: R31.2, U13.12 (R1OUT)
unnamed: R30.2, U13.11 (T1IN)
unnamed: C28.2, C29.1, FB4.1, U13.16 (VCC)
unnamed: C32.1, U13.2 (VS+)
unnamed: C33.1, U13.6 (VS-)
unnamed: R34.2, U14.2 (~RE), U14.3 (DE)
unnamed: R35.2, U14.4 (DI)
unnamed: R32.2, U14.1 (RO)
unnamed: C36.2, C37.1, FB5.1, U14.8 (VCC)
RPI_RX1: R31.1; also elsewhere on the board
RPI_TX1: R30.1; also elsewhere on the board
RS485_D/R: R34.1; also elsewhere on the board
RS485_RX: R32.1; also elsewhere on the board
RS485_TX: R35.1; also elsewhere on the board

Notes on the sheet:
RS485_B
DİREK GNDYE BAGLANMALIMI
RS485_A
kapasiteler mümkün olduğunda konnektör yakınına
RS232_GND
RS232_RX
RS232_TX
RS485_GND
RS485 EKLENECEK VE 4-20mA analog input

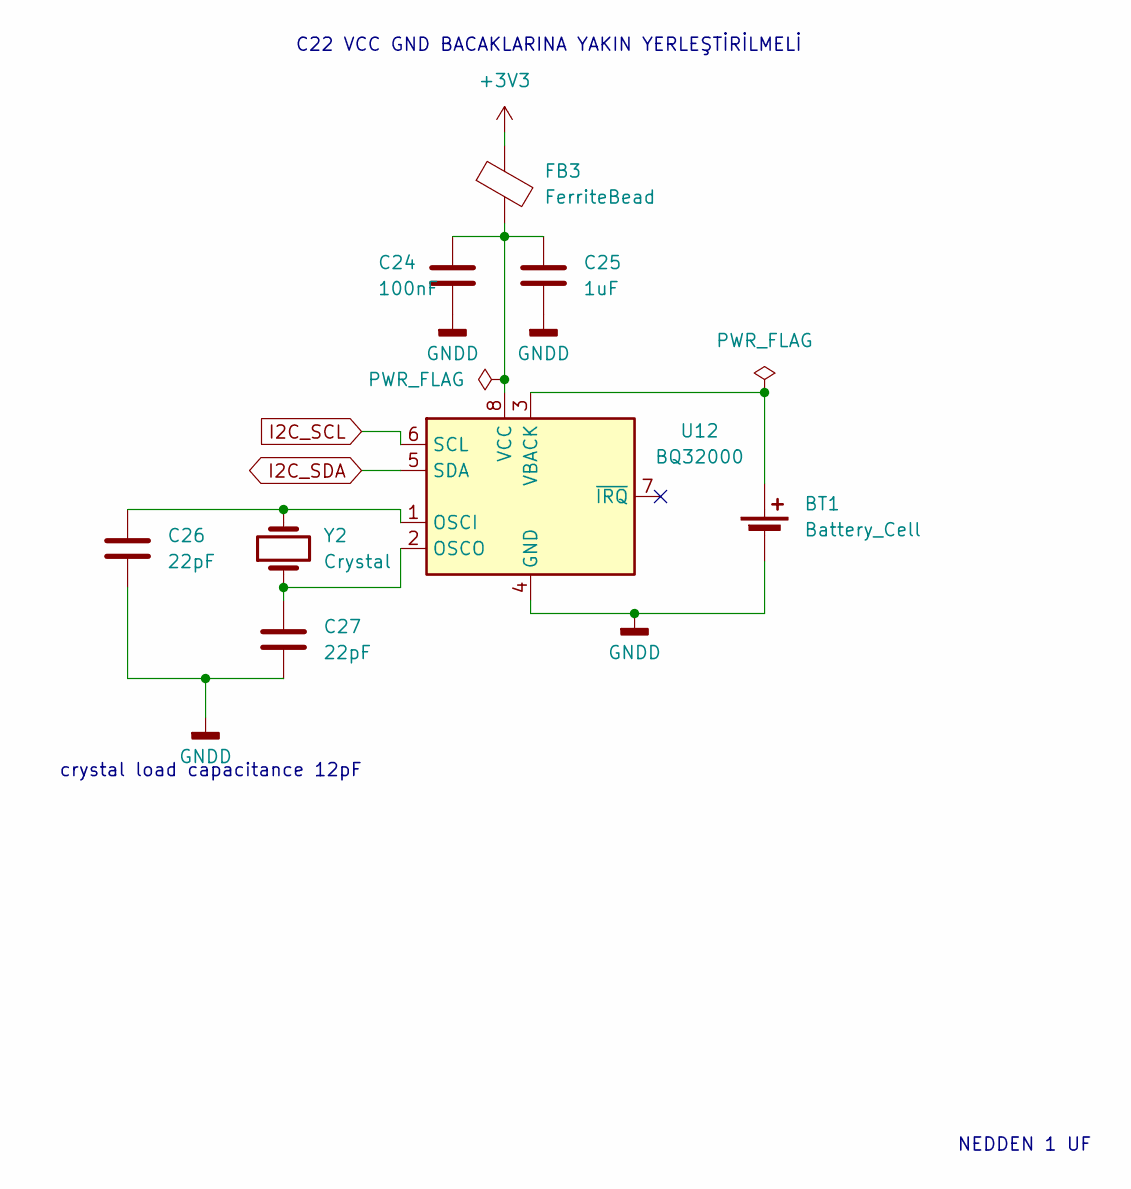
[picture p25: schematic rtc.kicad_sch]

Parts:
BT1: Battery_Cell; BatteryHolder_CR2032
C24: 100nF; C_0805_2012Metric
C25: 1uF; C_0805_2012Metric
C26, C27: 22pF; C_0805_2012Metric
FB3: FerriteBead; L_0805_2012Metric
U12: BQ32000; SOIC-8_3.9x4.9mm_P1.27mm
Y2: Crystal; Crystal_Round_D3.0mm_Vertical

Connections:
+3V3: FB3.1; also elsewhere on the board
GNDD: BT1.2 (-), C24.2, C25.1, C26.1, C27.1, U12.4 (GND); also elsewhere on the board
I2C_SCL: U12.6 (SCL); also elsewhere on the board
I2C_SDA: U12.5 (SDA); also elsewhere on the board
unnamed: BT1.1 (+), U12.3 (VBACK)
unnamed: C26.2, U12.1 (OSCI), Y2.2
unnamed: C27.2, U12.2 (OSCO), Y2.1
unnamed: C24.1, C25.2, FB3.2, U12.8 (VCC)

Notes on the sheet:
crystal load capacitance 12pF
C22 VCC GND BACAKLARINA YAKIN YERLEŞTİRİLMELİ
NEDDEN 1 UF

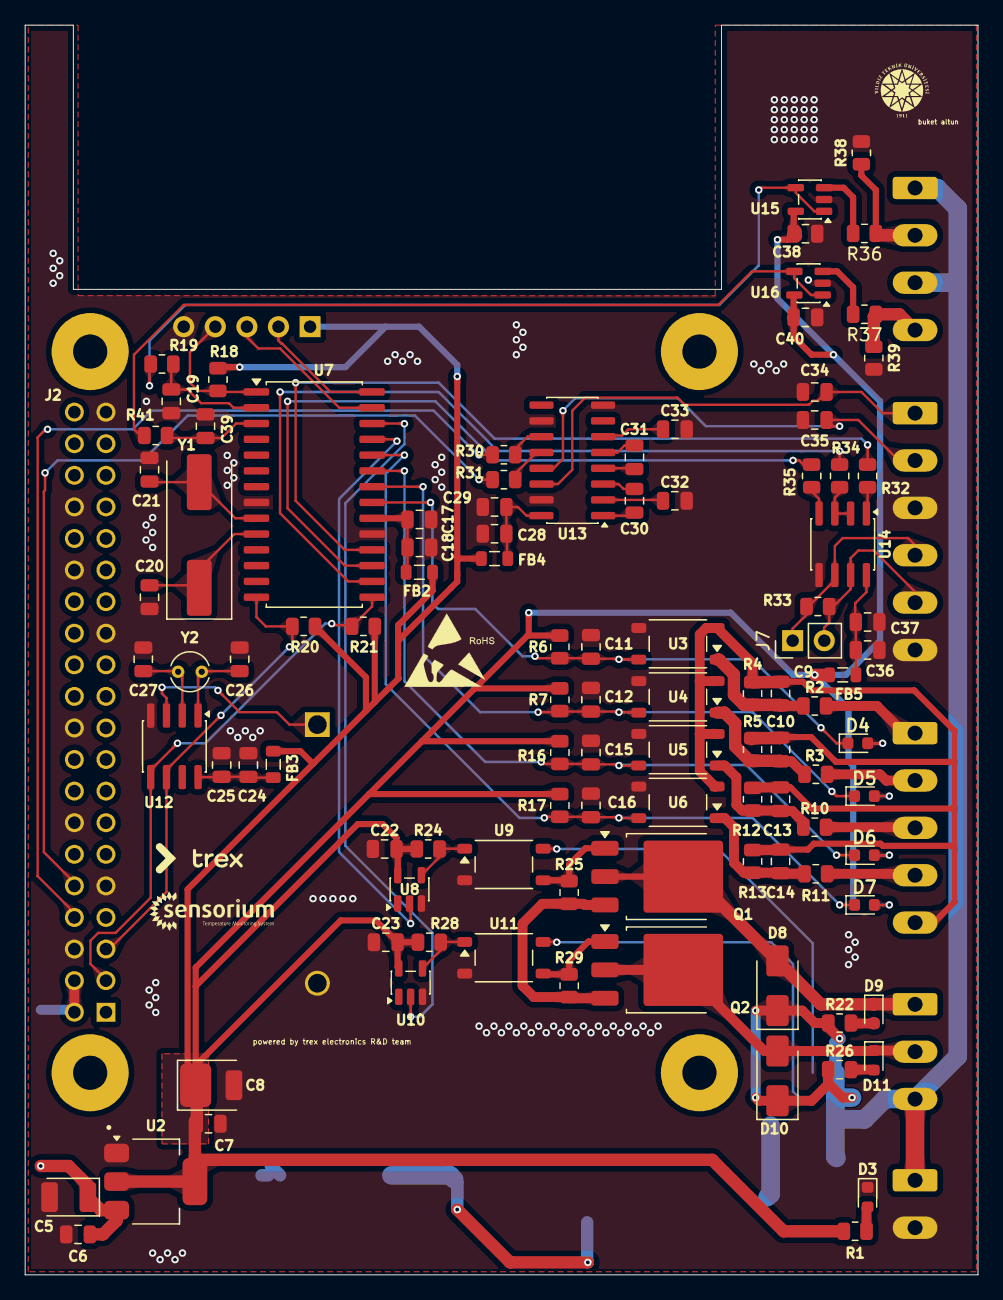
[picture p26: board staj_proje(v3_blue).kicad_pcb from above]

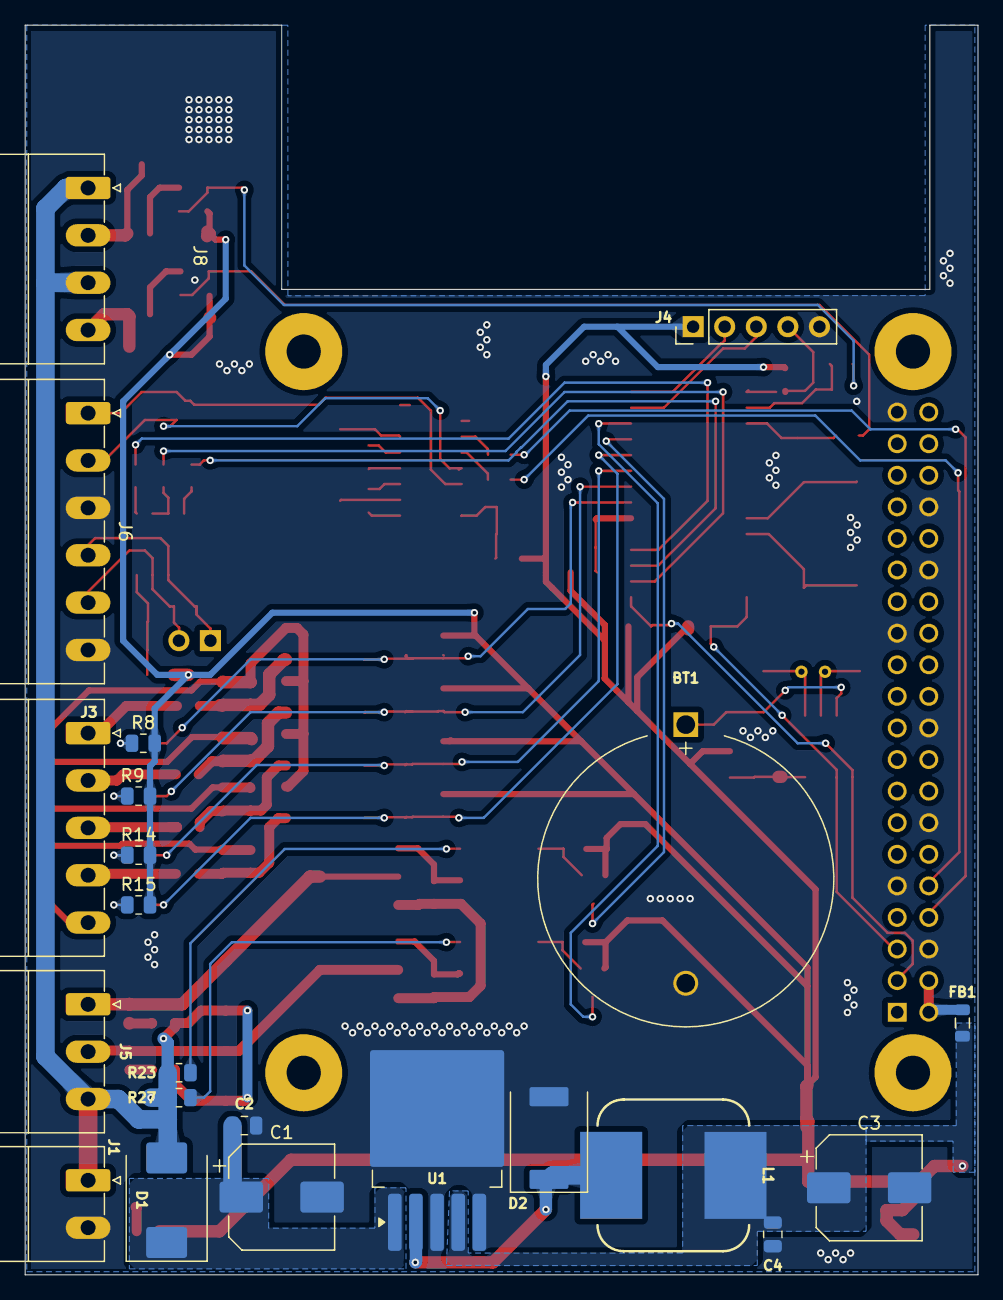
[picture p27: board staj_proje(v3_blue).kicad_pcb from below]

Board: 2 copper layers, 76.6 x 100.5 mm, 126 parts (22 on the bottom side), 80 nets.
